stm32-hotspot/STM32WBA-Advanced-BLE-Broadcast-Speaker/Utilities/Media/speaker.png

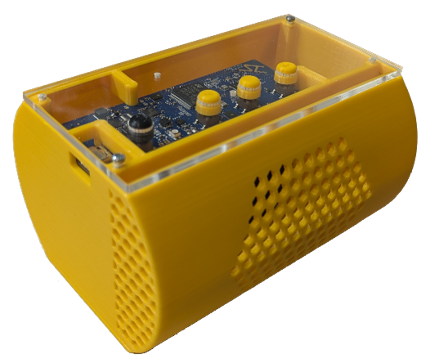
Utilities/Media/speaker.png
