stm32-hotspot/STM32WBA-Advanced-BLE-Broadcast-Speaker/Hardware/BLE_Speaker/BOM/BLE_Speaker_BOM.xlsx

 |  |  | Bill of materials
 |  |  | Board reference: | BLE_SPEAKER
 |  |  | Variant: | Variant for production
 |  |  | PCB revision: | revB
 |  |  | Assembly revision:
 |  |  | Date: | 11/8/2024
Designator | Description | Package | Manufacturer | Manufacturer_Part_Number | Fitted | Quantity | Alternate | Note
ANT1 | ST printed PCB Antenna for BLE miniboard and module |  | N/A | N/A | Fitted | 1
B1, B2, B3, B4 | Push Button, NO, 0.05A, 12V | 6,2x6,2mm | WURTH ELECTRONIK | 430182095816 | Fitted | 4
C1 | Capacitor, Tantalum, 100uF, 6V3, 40mR, +/-20%, Type_B (3528 metric), T=1.9mm | 3528 (metric) | AVX | TCJB107M006R0040 | Fitted | 1
C2, C9, C10, C14, C21, C23, C24, C25, C30, C31, C34, C35, C43, C46, C48, C56, C60, C65, C70, C74, C88, C93, C94, C95, C96, C100, C101 | Capacitor, MLCC, 100nF,10V, X5R, +/-10%, 0201, T=0.3mm | 0201 | TDK | C0603X5R1A104K030BC | Fitted | 27
C3, C5, C26, C73 | Capacitor, MLCC, 470nF, 25V, X5R, +/-10%, 0402, T=0.5mm | 0402 | YAGEO | CC0402KRX5R8BB474 | Fitted | 4
C4, C6, C20, C85 | Capacitor, MLCC, 330pF, 50V, NPO, +/-5%, 0402, T=0.5mm | 0402 | YAGEO | CC0402JRNPO9BN331 | Fitted | 4
C7, C8, C11, C33, C50, C51, C52, C53, C61, C62, C64, C68, C75, C78, C79, C81, C91, C92 | Capacitor, MLCC, 1uF, 10V, X5R, +/-10%, 0402, T=0.5mm | 0402 | YAGEO | CC0402KRX5R6BB105 | Fitted | 18
C12, C13, C19, C22, C37, C40, C41, C42, C54, C71, C72, C82, C83 | Capacitor, MLCC, 10uF, 6.3V, X5R, +/-20%, 0402, T=0.5mm | 0402 | MURATA | GRM155R60J106ME05D | Fitted | 13
C15, C16 | Capacitor, MLCC, 10pF, 50V, NPO, +/-5%, 0402, T=0.5mm | 0402 | YAGEO | CC0402JRNPO9BN100 | Fitted | 2
C27, C28, C29 | Capacitor, MLCC, 2.2pF, 50V, NPO, +/-0.1pF, 0402, T=0.5mm | 0402 | YAGEO | CC0402BRNPO9BN2R2 | Fitted | 3
C36, C39, C44, C45, C47, C49, C66, C69 | Capacitor, MLCC, 4.7uF, 6V3, X5R, +/-20%, 0402, T=0.5mm | 0402 | MURATA | GRM155R60J475ME47 | Fitted | 8
C63, C77 | Capacitor, MLCC, 2.2uF, 6V3, X5R,+/-10%, 0402, T=0.5mm | 0402 | MURATA | GRM155R60J225KE95D | Fitted | 2
C76, C84 | Capacitor, MLCC, 22uF, 10V, X5R, +/-20%, 0603, T=0.8mm | 0603 | YAGEO | CC0603MRX5R6BB226 | Fitted | 2
C80, C87 | Capacitor, MLCC, 10pF, 25V, NPO, +/-5%, 0201, T=0.3mm | 0201 | MURATA | GJM0335C1E100JB01 | Fitted | 2
C86 | Capacitor, MLCC, 33pF, 50V, NPO,+/-5%, 0402, T=0.5mm | 0402 | YAGEO | CC0402JRNPO9BN330 | Fitted | 1
CN6 | USB_TypeC, 24 pins, RA, SMD, T=3.71mm (USB Certified 3.1) |  | MOLEX | 2012670005 | Fitted | 1
L1, L2 | Ferrite bead, 600R @ 100MHz, +/-25%, 1300mA, 150mR, 0603, T=0.95mm | 0603 | MURATA | BLM18KG601SN1D | Fitted | 2
L3 | Inductor, 1.3nH, +/-0.3nH, 1A, 70mR, 0402, T=0.5mm | 0402 | MURATA | LQG15HS1N3S02 | Fitted | 1
L4, L5 | Inductor, 2.2uH, +/-20%, 2,2A, 84mR, 1008, T=1.2mm | 1008 | TOKO | DFE252012P-2R2M=P2 | Fitted | 2
L6 | Ferrite bead, 26R @ 100Mhz, +/-25%, 6000mA, 0R007, 0603, T=0.75mm | 0603 | MURATA | BLM18KG260TN1 | Fitted | 1
L7, L9 | Inductor, 3.3uH, +/-30%, 3,83A, 0R023, 4x4mm, T=2.5mm | 4x4mm | WURTH ELEKTRONIK | 74404043033A | Fitted | 2
L8 | Inductor, 4.7uH, +/-20%, 1.2A, 114mR, 4040, T=1.2mm | 4040 (Metric) | TAIYO YUDEN | LSXND4040MKL4R7MDG | Fitted | 1
LD1 | LED, Orange, 2V, 20mA, 0603 | 0603 | VISHAY | VLMO1300-GS08 | Fitted | 1
LD2 | LED Multicolor, Red/Green/Blue, 2V/3V2/3V2, 20mA, 2.8x3.2mm | 2.8x3.2mm | WURTH ELEKTRONIK | 150141M173100 | Fitted | 1
Q1 | Transistor, MOSFET, P-CH, -20V, -3.2A, SOT23-3 | SOT23-3 | ON SEMICONDUCTOR | NTR4101PT1G | Fitted | 1
R1, R19 | Resistor, 750K, 0402, +/-1%, 1/16W | 0402 | YAGEO | RC0402FR-07750KL | Fitted | 2
R2, R3, R20, R24 | Resistor, 10K, 0402, +/-1%, 1/16W | 0402 | YAGEO | RC0402FR-0710KL | Fitted | 4
R4, R9, R32, R33, R35 | Resistor, 100R, 0402, +/-1%, 1/16W | 0402 | YAGEO | RC0402FR-07100RL | Fitted | 5
R5, R10, R23, R28, R34, R36, R37, R38 | Resistor, 100K, 0402, +/-1%, 1/16W | 0402 | YAGEO | RC0402FR-07100KL | Fitted | 8
R6, R7 | Resistor, 51K, 0402, +/-1%, 1/16W | 0402 | YAGEO | RC0402FR-0751KL | Fitted | 2
R11 | Resistor, 49R9, 0402, +/-1%, 1/16W | 0402 | YAGEO | RC0402FR-0749R9L | Fitted | 1
R12, R15, R18, R29 | Resistor, 1K, 0402, +/-1%,1/16W | 0402 | YAGEO | RC0402FR-071KL | Fitted | 4
R13, R14 | Resistor, 5K1, 0402, +/-1%, 1/16W | 0402 | YAGEO | RC0402FR-075K1L | Fitted | 2
R17 | Resistor, 0R010, 1206 ,+/-1%, 1W | 1206 | PANASONIC | ERJ8CWFR010V | Fitted | 1
R21 | Resistor, 243K, 0402, +/-1%, 1/16W | 0402 | YAGEO | RC0402FR-07243KL | Fitted | 1
R22, R31 | Resistor, 560K, 0402, +/-1%, 1/16W | 0402 | YAGEO | RC0402FR-07560KL | Fitted | 2
R25 | NTC Thermistor, 10k, 0201, +/-1%@25°C, 100mW | 0201 | TDK | NTCG063JF103FTDS | Fitted | 1
R26 | Resistor, 10R, 0402, +/-1%, 1/16W | 0402 | YAGEO | RC0402FR-0710RL | Fitted | 1
R27 | Resistor, 2K49, 0402, +/-1%, 1/16W | 0402 | YAGEO | RC0402FR-072K49L | Fitted | 1
SB1, SB2, SB6, SB18, SB20 | Solder Bridge ON, 0R, 0201, 1/20W | 0201 | YAGEO | RC0201JR-070RL | Fitted | 5
U1 | Audio Amplifiers 1.2W audio pow. amp. |  | STMICROELECTRONICS | TS4962IQT | Fitted | 1
U2 | LDO Voltage Regulators Linear Voltage Regulators & Vref | DFN6 3x3 | STMICROELECTRONICS | LDL212PU50R | Fitted | 1
U3, U4 | MEMS, audio sensor, omnidirectional digital microphone | HCLGA-4 | STMICROELECTRONICS | MP34DT05TR | Fitted | 2
U5 | LDO, 200mA, Very low quiescent current linear regulator IC | DFN-4 | STMICROELECTRONICS | LD39020ADTPU18R | Fitted | 1
U6 | MCU,ARM Cortex M33,1MB Flash, 128KB SRAM, Crypto, RF 2.4GHz, BLE, 802.15.4 | UFQFPN48 7X7 0.55 | STMICROELECTRONICS | STM32WBA55CGU6 | Fitted | 1
U7 | IC, Gas gauge IC with alarm output for handheld applications | DFN-10 | STMICROELECTRONICS | STC3115AIQT | Fitted | 1
U9 | Stereo Codec, Ultra-Low power stereo audio codec | TQFN-EP-32 | ANALOG DEVICES | MAX9867ETJ+ | Fitted | 1
U11, U13, U14, U15, U16 | Diode, ESD TVS, 5V5, 1.5uA, 6V8, QFN1610 | QFN1610 | STMICROELECTRONICS | ESDA7P120-1U1M | Fitted | 5
U12 | High Efficiency USB Power Manager with Dual Buck and Buck-Boost DC/DC, 4.35 to 5.5 V Vin, 28-pin QFN (UFD-28), -40 to 85 degC, Pb-Free |  | Analog Devices / Linear Technology | LTC3556EUFD#PBF | Fitted | 1
U17 | ARM Microcontrollers - MCU Arm Cortex-M33 32-bit 250 MHz 2 Mbytes Flash 640KB RAM I3C, DCMI, Ethernet, SMPS |  | STMICROELECTRONICS | STM32H563VIT3Q | Fitted | 1 | STM32H573VIT3Q
U18 | IC, ESD protection and Common Filter High Speed serial Interfaces, 10.7 GHz | uQFN-6 | STMICROELECTRONICS | ECMF2-40A100N6 | Fitted | 1
X1 | Crystal, 32.768kHz, 9pF, +/-20ppm, 70KR, 1.6x1mm | 1.6x1.0mm | NDK | NX1610SE-32.768KHZ-EXS00A-MU01499 | Fitted | 1
X2 | Crystal, 32MHz, 8pF, +/-10ppm, 60R, 2x1.6mm | 2.0x1.6mm | NDK | NX2016SA-32MHZ-EXS00A-CS06654 | Fitted | 1
C17, C18 | Capacitor, MLCC, 3.9pF, 50V, NPO, +/-0.1pF, 0402, T=0.5mm | 0402 | YAGEO | CC0402BRNPO9BN3R9 | Not Fitted | 0
C32, C67, C98 | Capacitor, MLCC, 330pF, 50V, NPO, +/-5%, 0402, T=0.5mm | 0402 | YAGEO | CC0402JRNPO9BN331 | Not Fitted | 0
C38, C99 | Capacitor, MLCC, 1uF, 10V, X5R, +/-10%, 0402, T=0.5mm | 0402 | YAGEO | CC0402KRX5R6BB105 | Not Fitted | 0
C55, C97 | Capacitor, MLCC, 470nF, 25V, X5R, +/-10%, 0402, T=0.5mm | 0402 | YAGEO | CC0402KRX5R8BB474 | Not Fitted | 0
C57, C59 | Capacitor, MLCC, 10pF, 50V, NPO, +/-5%, 0402, T=0.5mm | 0402 | YAGEO | CC0402JRNPO9BN100 | Not Fitted | 0
C58 | Capacitor, MLCC, 100nF,10V, X5R, +/-10%, 0201, T=0.3mm | 0201 | TDK | C0603X5R1A104K030BC | Not Fitted | 0
C89 | Capacitor, MLCC, 10pF, 25V, NPO, +/-5%, 0201, T=0.3mm | 0201 | MURATA | GJM0335C1E100JB01 | Not Fitted | 0
C90 | Capacitor, MLCC, 10uF, 6.3V, X5R, +/-20%, 0402, T=0.5mm | 0402 | MURATA | GRM155R60J106ME05D | Not Fitted | 0
CN1, CN4 | Header, 2x1, 2.54mm, VR, TH, T=5.84mm/2.54mm |  | SAMTEC | TSW-102-07-G-S | Not Fitted | 0
CN2, CN5 | Header, 7x2, 1.27mm, VR, SMD, T=6.12mm |  | SAMTEC | FTSH-107-01-L-DV-K | Not Fitted | 0
CN3 | Connector_RF, 0Hz to 6GHz, 50R, VR, SMD, T= 1.25mm |  | HIROSE | U.FL-R-SMT-1 | Not Fitted | 0
CN7 | Header, 3x1, 2.54mm, VR, TH, T=6mm/3mm |  | JIUBABA | PHFS25-11-03-G0B115-T-1 | Not Fitted | 0
L10 | Inductor, 4.7uH, +/-20%, 1.2A, 114mR, 4040, T=1.2mm | 4040 (Metric) | TAIYO YUDEN | LSXND4040MKL4R7MDG | Not Fitted | 0
L11, L12 | Ferrite bead, 600R @ 100MHz, +/-25%, 1300mA, 150mR, 0603, T=0.95mm | 0603 | MURATA | BLM18KG601SN1D | Not Fitted | 0
R8, R39, R40, R43 | Resistor, 120K, 0402, +/-0.1%, 1/16W, +/-25ppm/°C | 0402 | YAGEO | RT0402BRD07120KL | Not Fitted | 0
R30 | Resistor, 750K, 0402, +/-1%, 1/16W | 0402 | YAGEO | RC0402FR-07750KL | Not Fitted | 0
R41, R42 | Resistor, 51K, 0402, +/-1%, 1/16W | 0402 | YAGEO | RC0402FR-0751KL | Not Fitted | 0
SB3, SB4, SB5, SB7, SB15, SB16 | Solder Bridge ON, 0R, 0201, 1/20W | 0201 | YAGEO | RC0201JR-070RL | Not Fitted | 0
U8 | Audio Amplifiers 1.2W audio pow. amp. | DFN8 3x3 p0.65 |  | TS4990IQT | Not Fitted | 0
X3 | Crystal, 32.768kHz, 9pF, +/-20ppm, 70KR, 1.6x1mm | 1.6x1.0mm | NDK | NX1610SE-32.768KHZ-EXS00A-MU01499 | Not Fitted | 0
