stm32-hotspot/STM32WBA-Advanced-BLE-Broadcast-Speaker/3D_Printings/Speaker_button_minus.stl

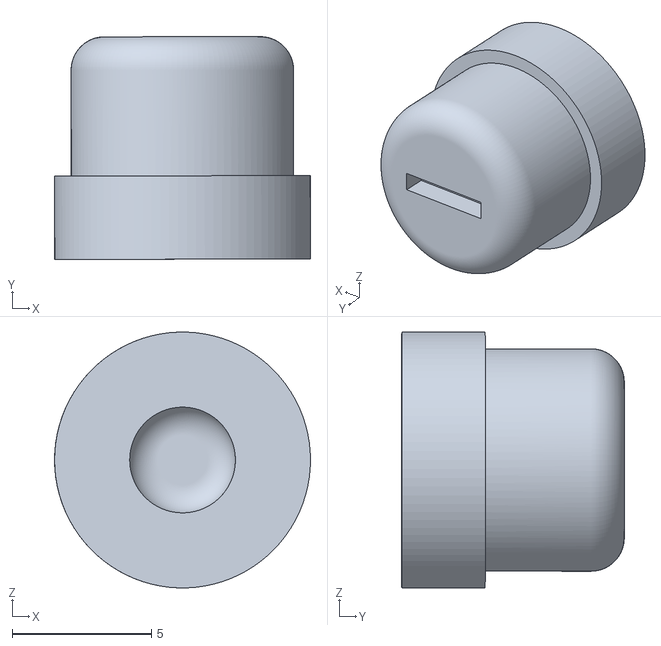
[picture p14: CAD file, 2025-11-28]
3D_Printings/Speaker_button_minus.stl
9.20 x 8.01 x 9.19
