stm32-hotspot/STM32WBA-Advanced-BLE-Broadcast-Speaker/3D_Printings/Speaker_button_plus.stl

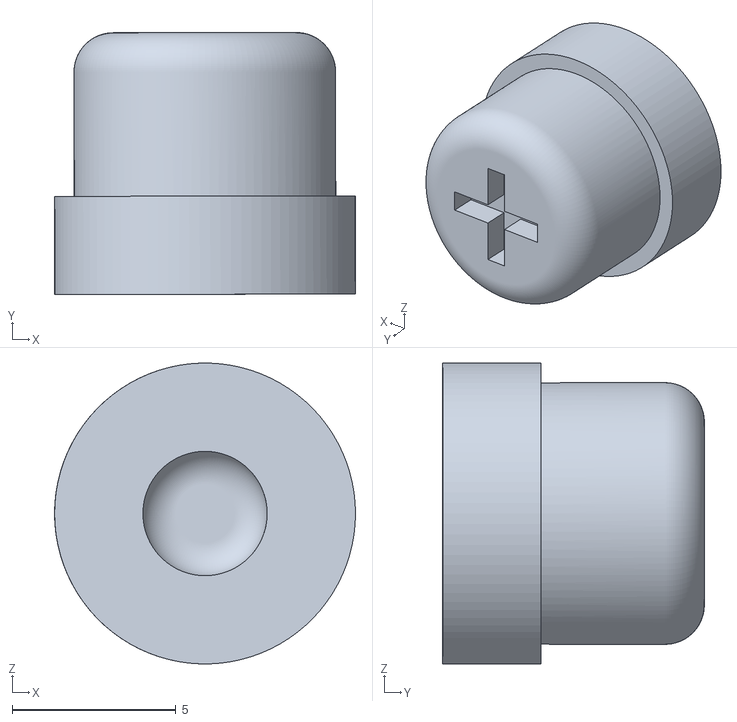
[picture p15: CAD file, 2025-11-28]
3D_Printings/Speaker_button_plus.stl
9.20 x 8.01 x 9.19
