stm32-hotspot/STM32WBA-Advanced-BLE-Broadcast-Speaker/3D_Printings/Speaker_bottom_cover.stl

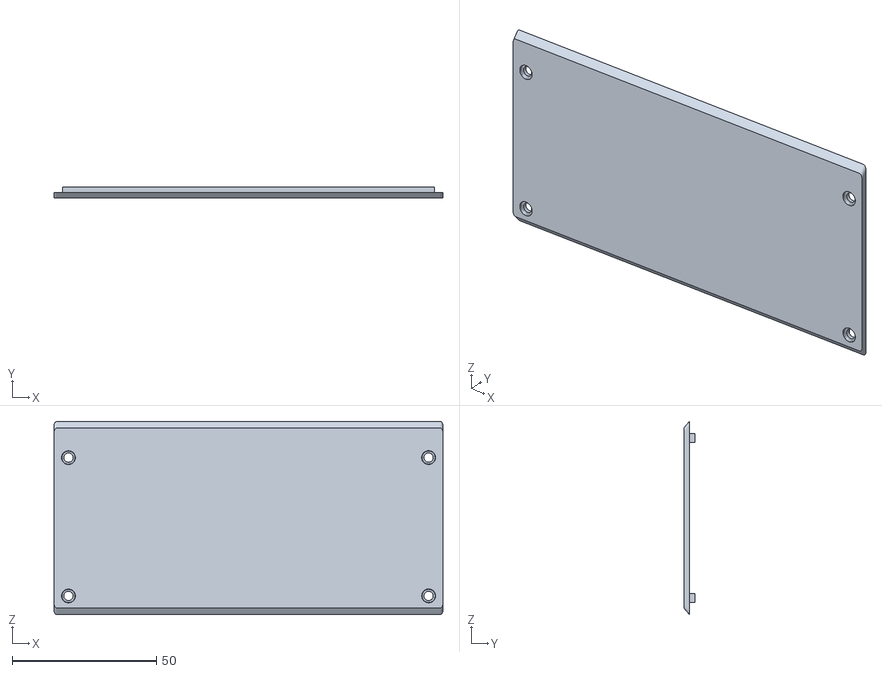
[picture p16: CAD file, 2025-11-28]
3D_Printings/Speaker_bottom_cover.stl
135.0 x 3.97 x 67.1
