stm32-hotspot/STM32WBA-Advanced-BLE-Broadcast-Speaker/3D_Printings/Speaker_top_cover_PMMA.dxf

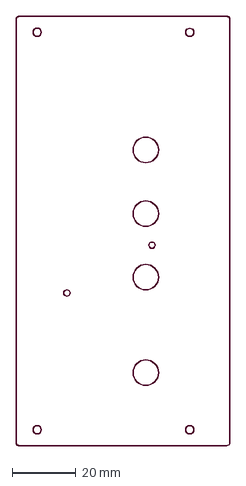
[picture p17: CAD file, 2025-11-28]
3D_Printings/Speaker_top_cover_PMMA.dxf
67.3 x 135.0 mm
