stm32-hotspot/STM32WBA-Advanced-BLE-Broadcast-Speaker/3D_Printings/Speaker_body.stl

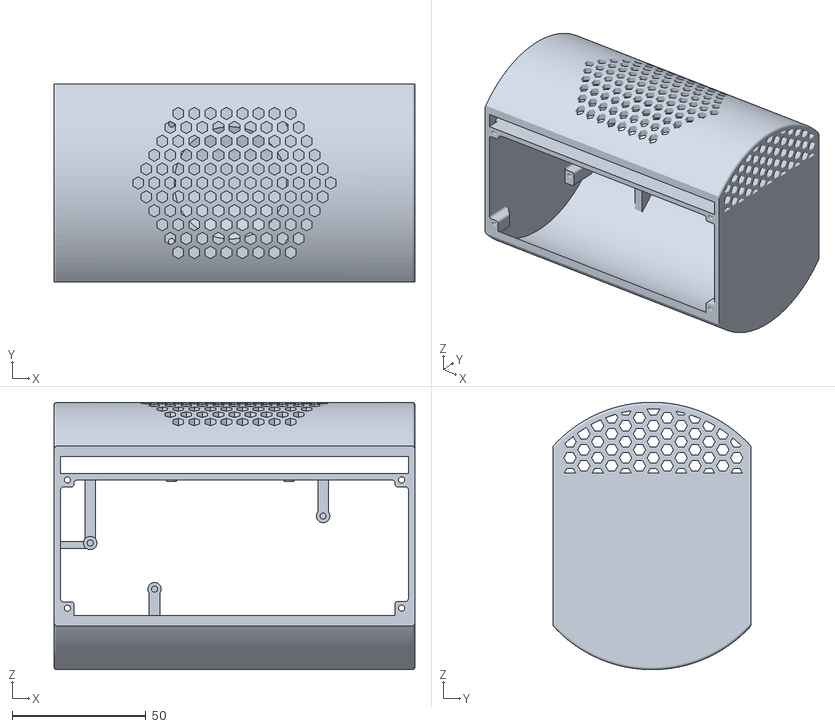
[picture p18: CAD file, 2025-11-28]
3D_Printings/Speaker_body.stl
135.0 x 74.0 x 100.0
