stm32-hotspot/STM32WBA-Advanced-BLE-Broadcast-Speaker/3D_Printings/Speaker_button_generic.stl

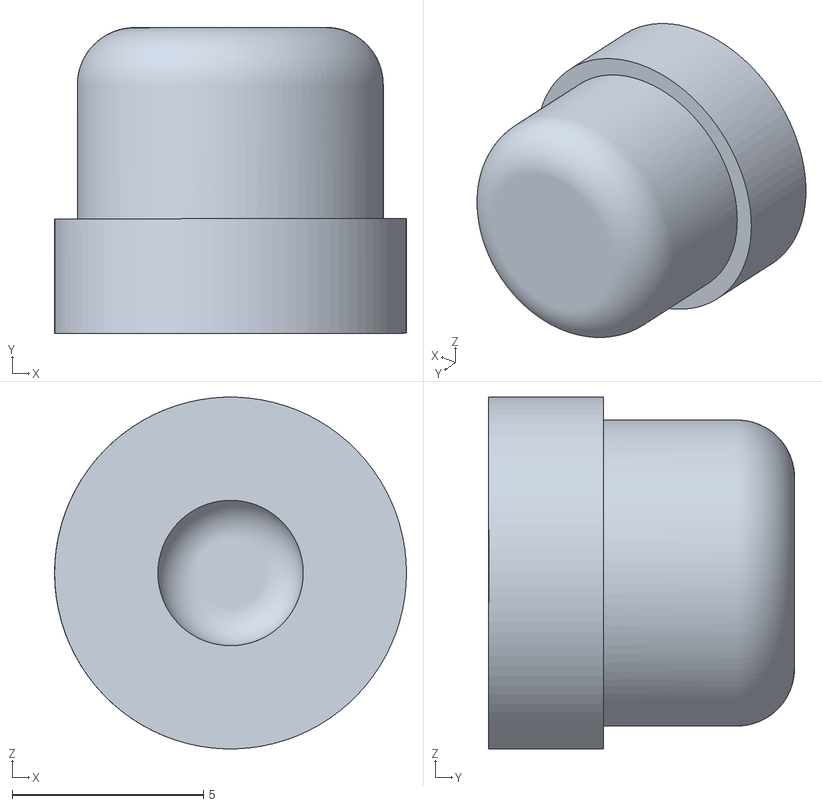
[picture p19: CAD file, 2025-11-28]
3D_Printings/Speaker_button_generic.stl
9.20 x 8.01 x 9.19
