stm32-hotspot/STM32WBA-Advanced-BLE-Broadcast-Speaker/Release_Notes.html

# Release Notes for

# STM32WBA-Advanced-BLE-Broadcast-Speaker demonstration

Copyright © 2025 STMicroelectronics

ST logo (https://www.st.com)

# Purpose

This package contains specific applications running on BLE Speaker board and STM32WBA55G-DK or STM32WBA65I-DK discovery kits. See README.md files for more details.

This example is based on the STM32CubeWBA_v1.7.0 (https://github.com/STMicroelectronics/STM32CubeWBA/releases/tag/v1.7.0) package and on the x-cube-audio-kit v1.3.0 (https://www.st.com/en/embedded-software/x-cube-audio-kit.html).

For further information about these components, see official package.

BLE_Audio_Broadcast_Speaker and BLE_Audio_PBP_Source_Multilanguage examples are being delivered as-is, not necessarily supported by ST.

Modified x-cube-audio-kit (Livetune) example is being delivered as-is, not necessarily supported by ST.

# Update History

V1.0.0 / 27-November-2025

## Main Changes

### Initial release of BLE_Audio_Broadcast_Speaker and BLE_Audio_PBP_Source_Multilanguage applications running on respectively STM32WBA55 component of BLE_Speaker board and STM32WBA55G-DK or STM32WBA65I-DK discovery kits

### Initial release of Livetune application running on STM32H573 component of BLE_Speaker board

## Components

### Refer to Release Notes of official STM32CubeWBA v1.7.0 package for details of Components (Drivers, Cortex-M CMSIS, STM32 CMSIS, STM32WBAxx_HAL_Driver, STM32WBAxxx-DK1, Middlewares, Utilities)

### Refer to Release Notes of official x-cube-audio-kit v1.3.0 package for details of Components (Drivers, Cortex-M CMSIS, STM32H5xx CMSIS, STM32H5xx_HAL_Driver, Middlewares, Utilities)

## Known Limitations

### None

## Development Toolchains and Compilers

### IAR Embedded Workbench for ARM (EWARM) toolchain from v9.60.3 + ST-Link for STM32WBA related project

### IAR Embedded Workbench for ARM (EWARM) toolchain from v9.40.1 + ST-Link for STM32H5 related project

### RealView Microcontroller Development Kit (MDK-ARM) 5.38

### STM32Cube IDE 1.18.1 + ST-Link

## Supported Devices and Boards

### BLE_Speaker board

### STM32WBA55G-DK1 board

### STM32WBA65I-DK1 board

## Dependencies

### None

For complete documentation on STM32WBAxx, visit: [www.st.com/stm32wba]

For complete documentation on STM32H5xx, visit: [www.st.com/stm32h5 (https://www.st.com/en/microcontrollers-microprocessors/stm32h5-series.html)]

This release note uses up to date web standards and, for this reason, should not be opened with Internet Explorer but preferably with popular browsers such as Google Chrome, Mozilla Firefox, Opera or Microsoft Edge.
