stm32-hotspot/STM32WBA-Advanced-BLE-Broadcast-Speaker/Hardware/BLE_Speaker/Schematic/BLE_Speaker_Schematic.PDF

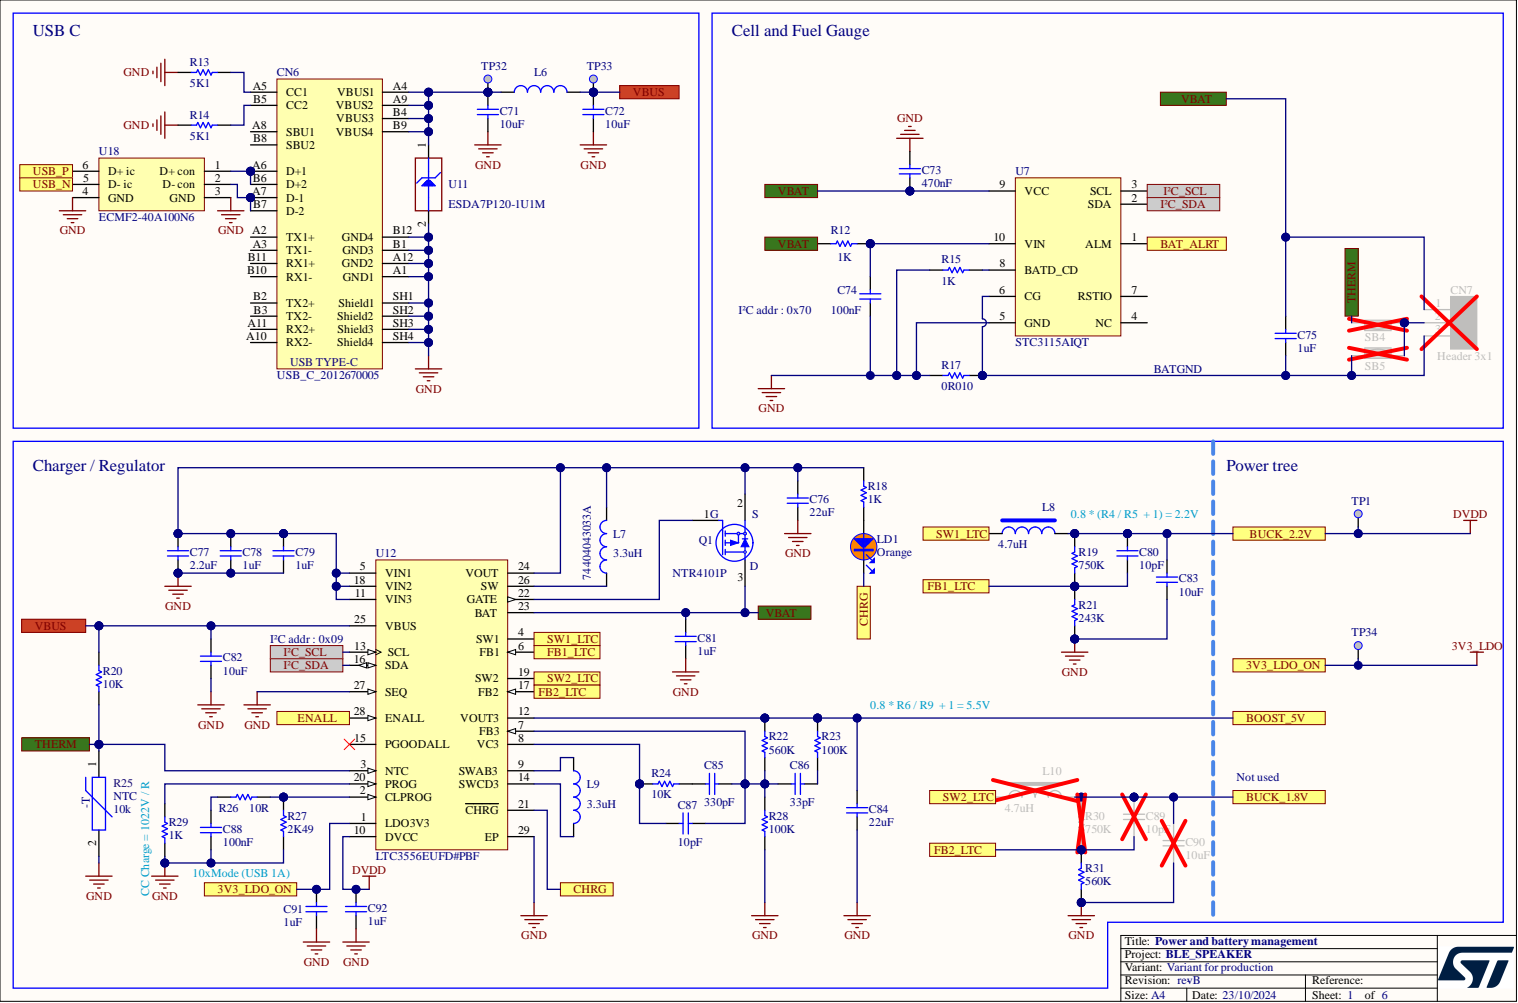
[picture p21: page 1]

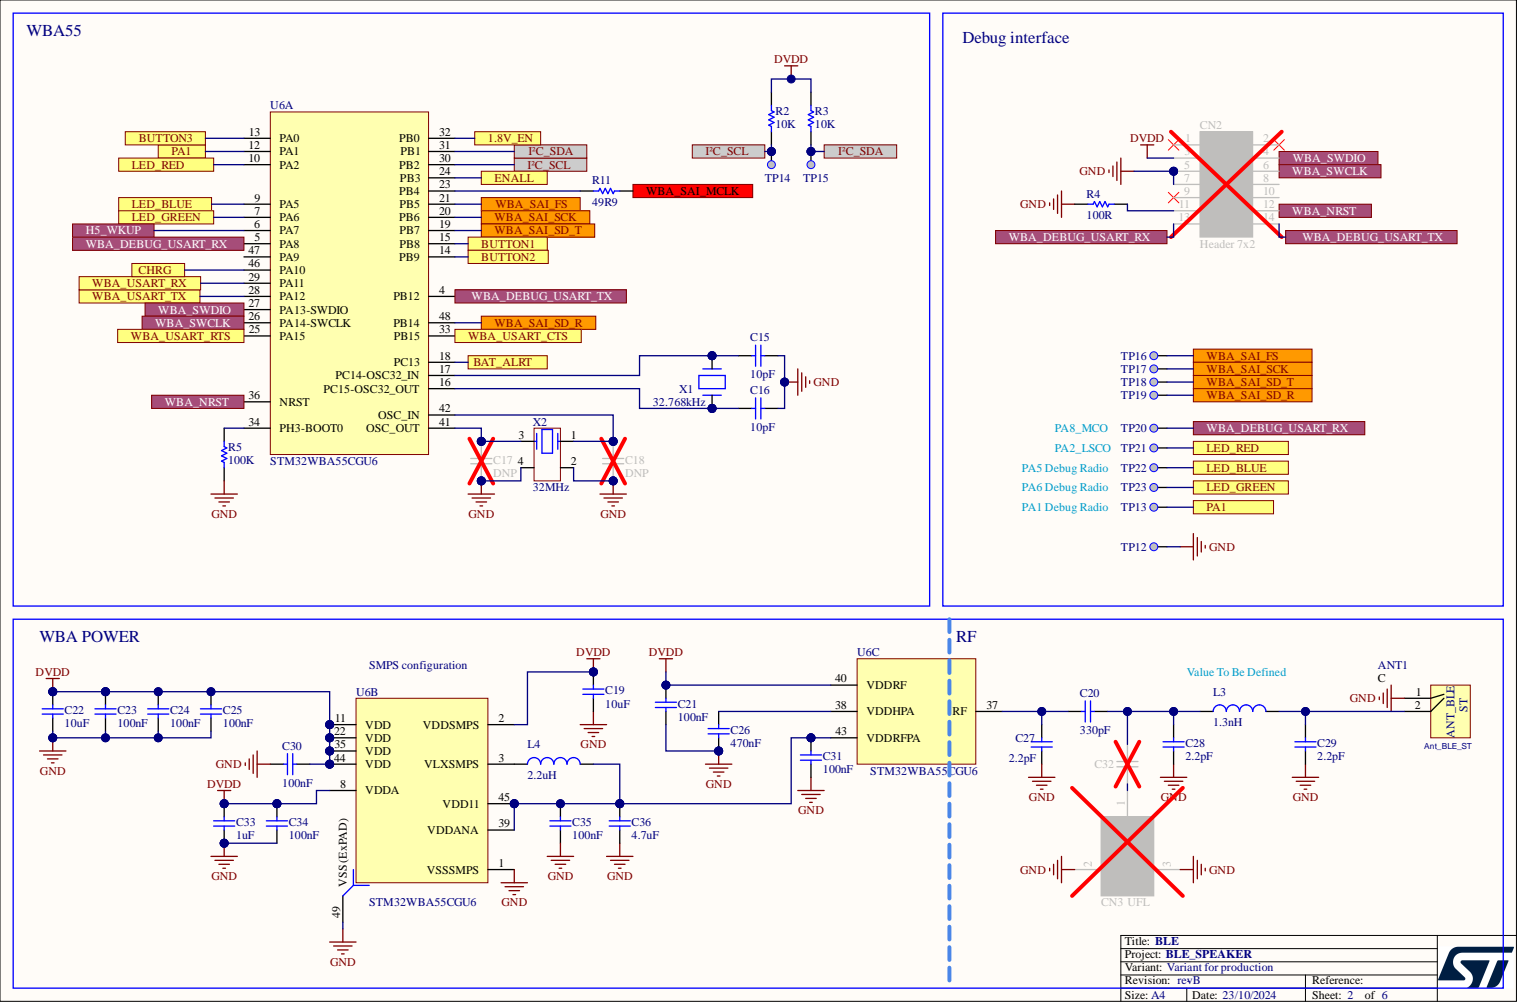
[picture p22: page 2]

Value To Be Defined

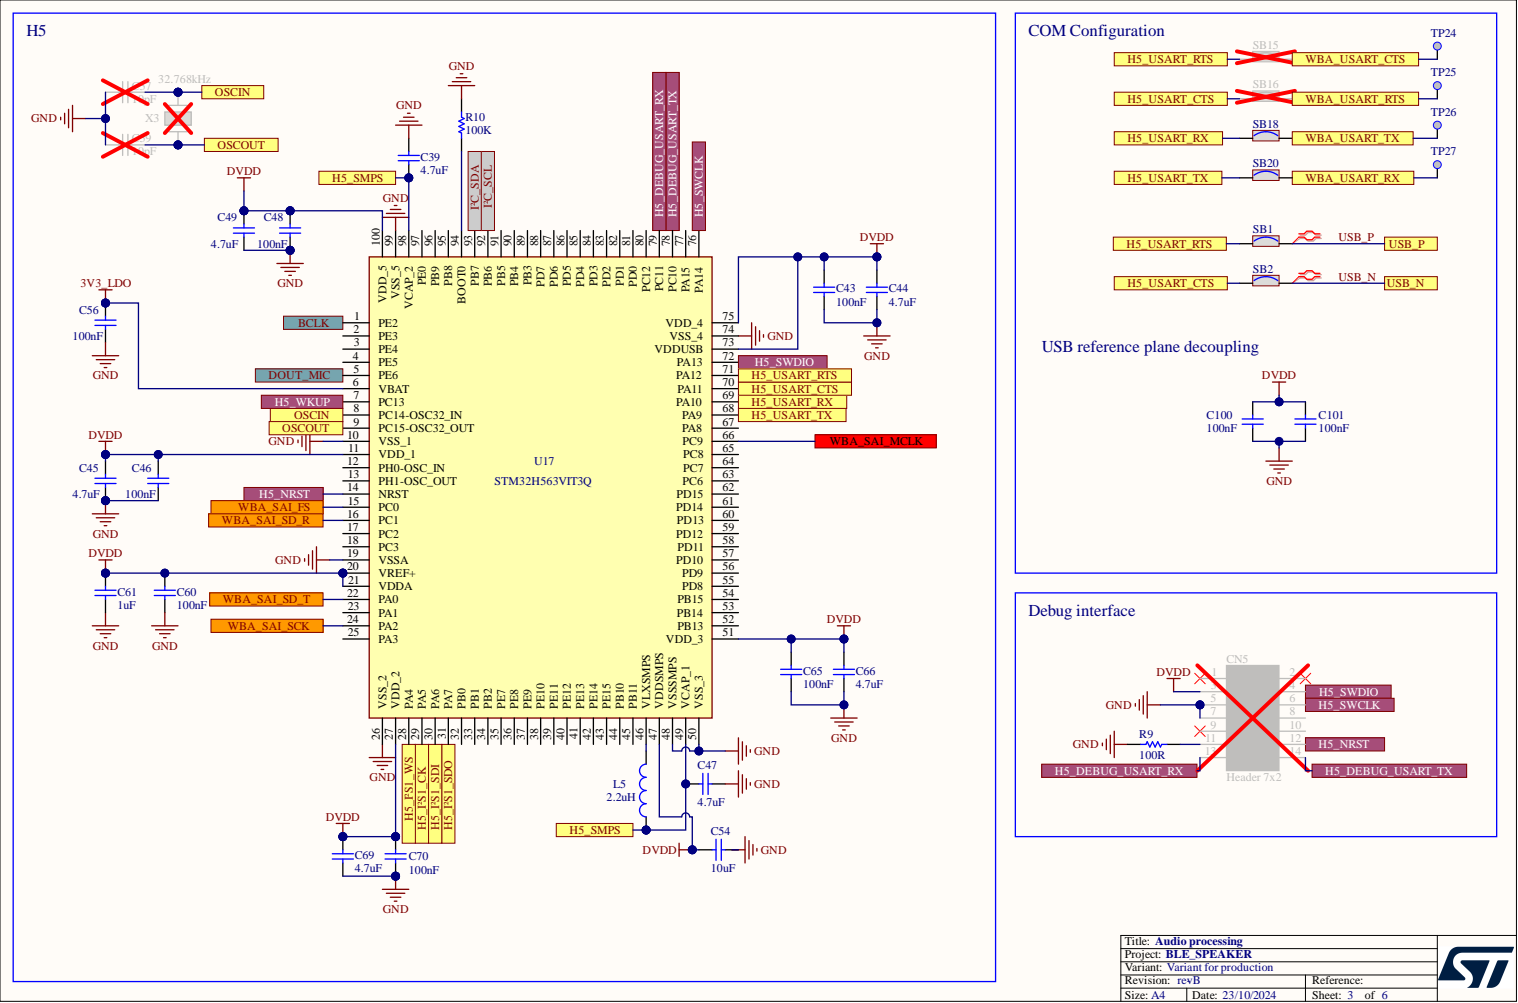
[picture p23: page 3]

2 | 7 4
3 | 7 3

USB reference plane decoupl

D O U T _ M I C | | | H 5 _ USA RT _RT S

5 | 7 1
6 | 7 0

1 5 | 6 1
1 6 | 6 0

2 0 | 5 6
2 1 | 5 5

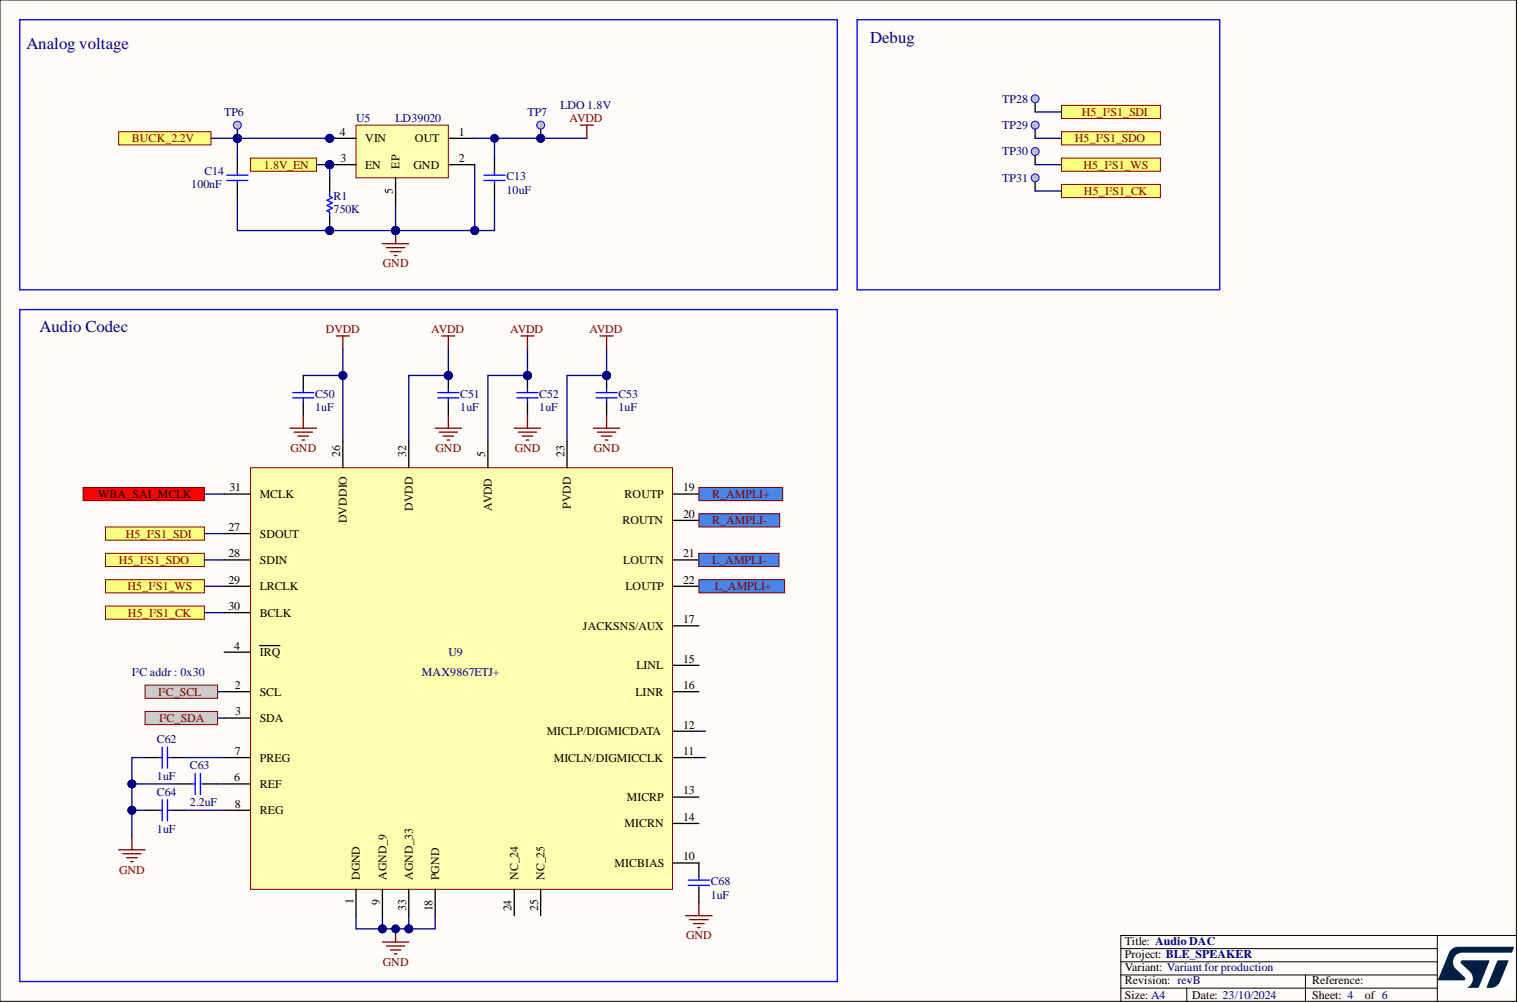
[picture p24: page 4]

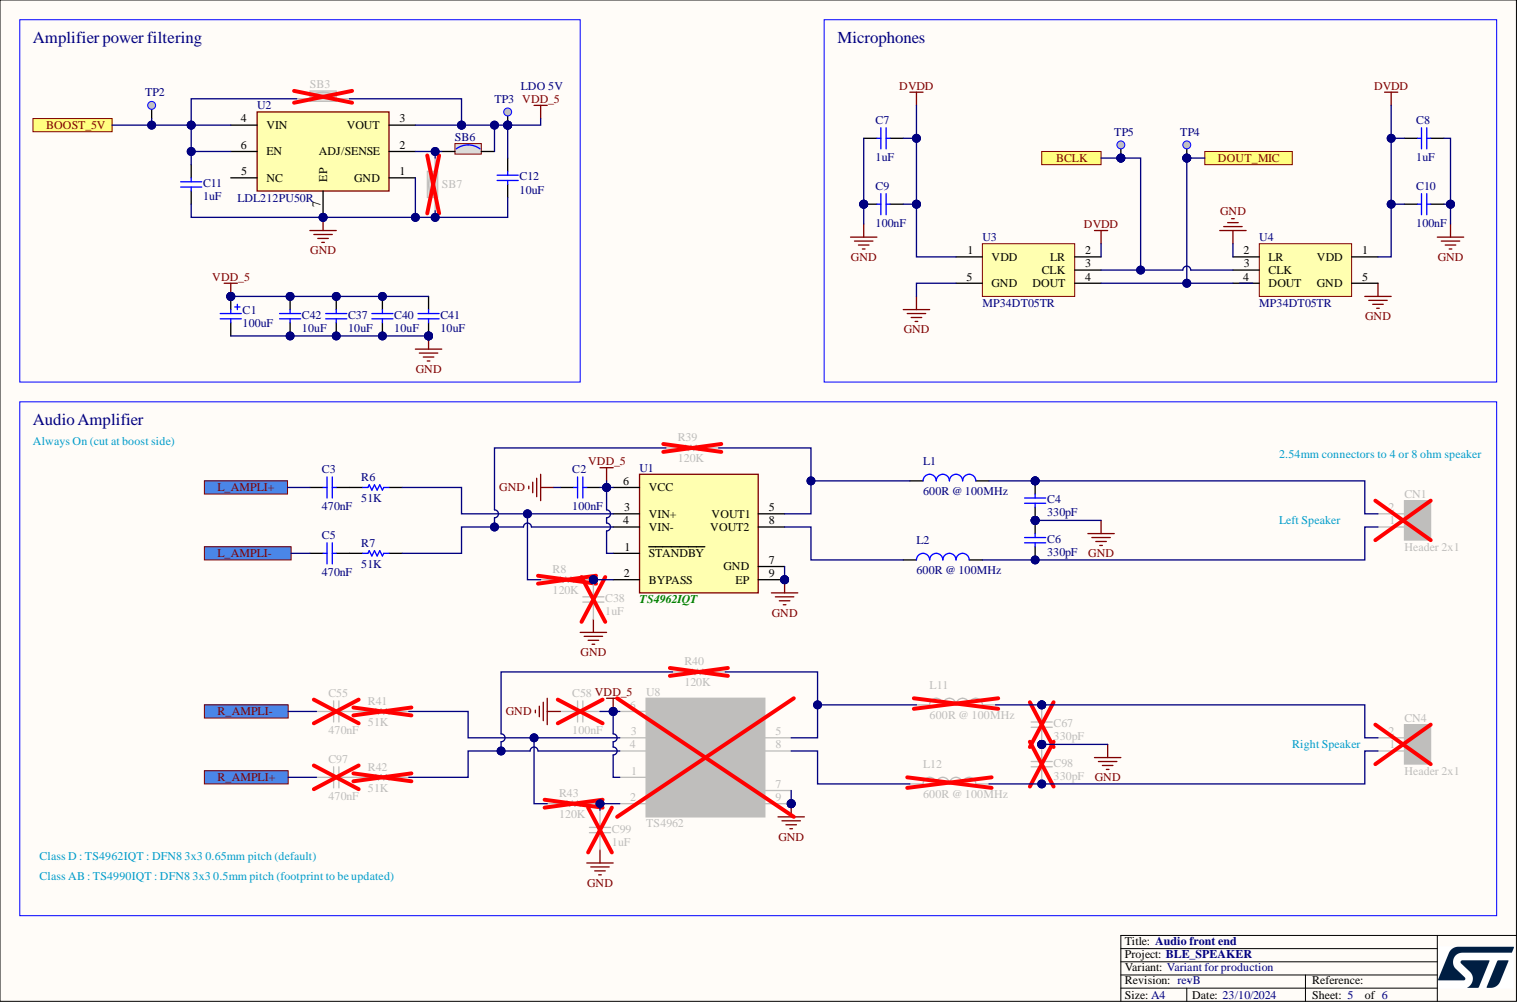
[picture p25: page 5]

Always On (cut at boost side)

2.54mm connectors to 4 or 8 ohm speaker

VCC 6

100nF | VIN+ 3

VCC 6 VIN+ 3 | VOUT2 GND

VIN- 4 | 8 | 1 1 2 2

STANDBY 1 | 7

Class D : TS4962IQT : DFN8 3x3 0.65mm pitch (default)
Class AB : TS4990IQT : DFN8 3x3 0.5mm pitch (footprint to be updated)

Title: Audio front end

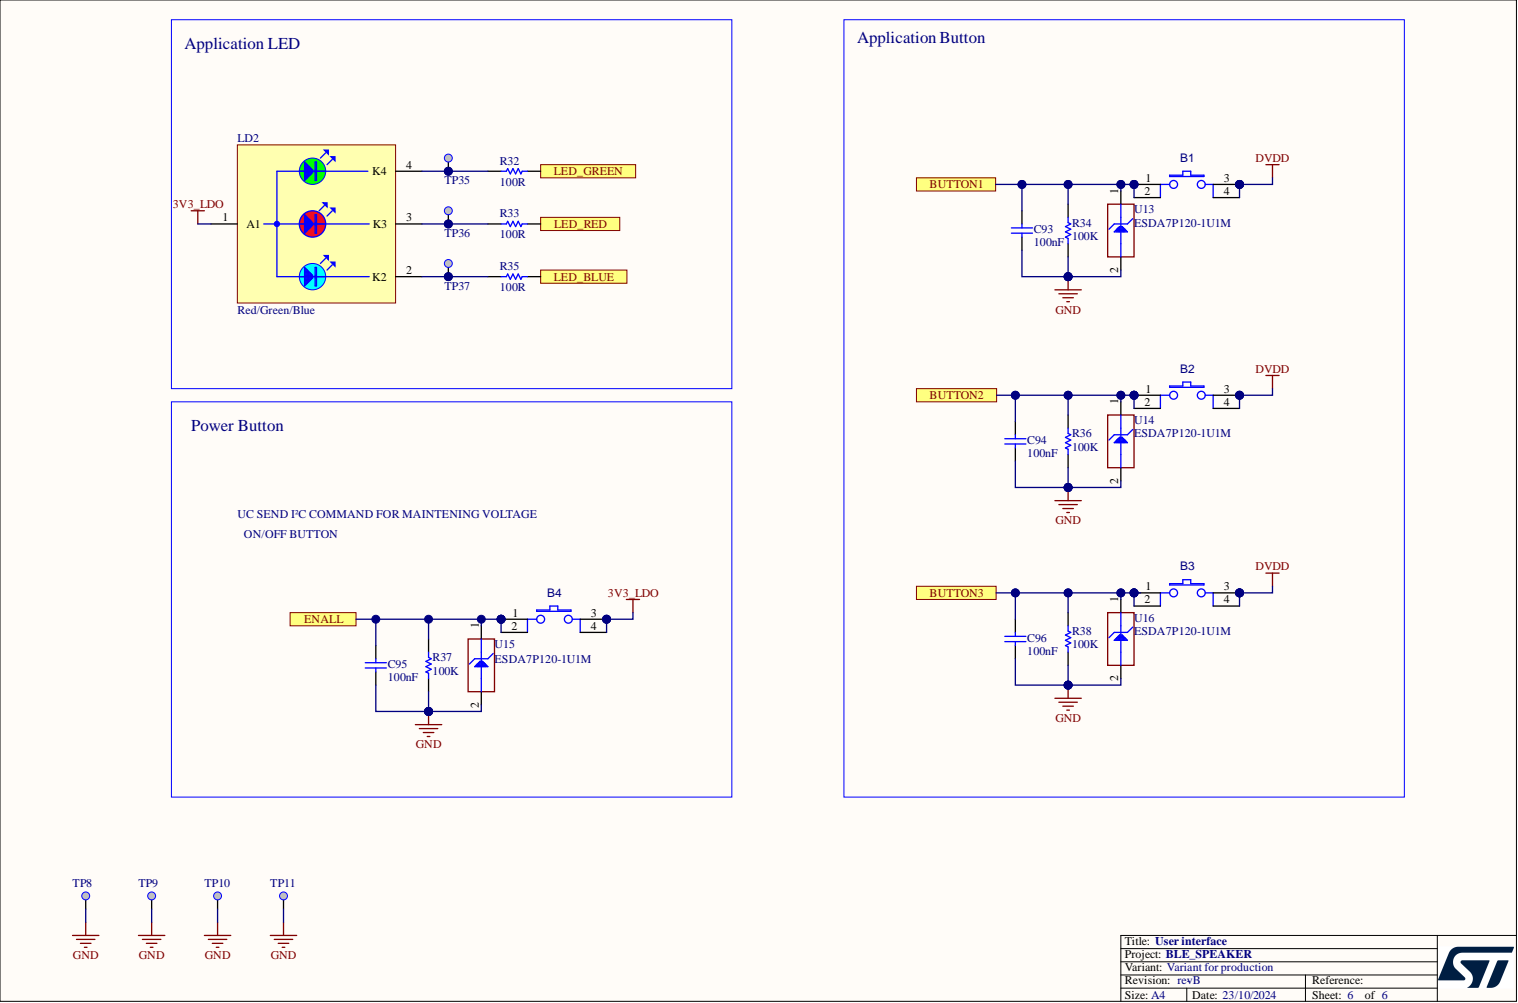
[picture p26: page 6]

UC SEND I²C COMMAND FOR MAINTENING VOLTAGE
ON/OFF BUTTON
