stm32-hotspot/STM32WBA-Advanced-BLE-Broadcast-Speaker/Hardware/BLE_Speaker/Manufacturing/Assembly/BLE_Speaker_revB_Assembly.PDF

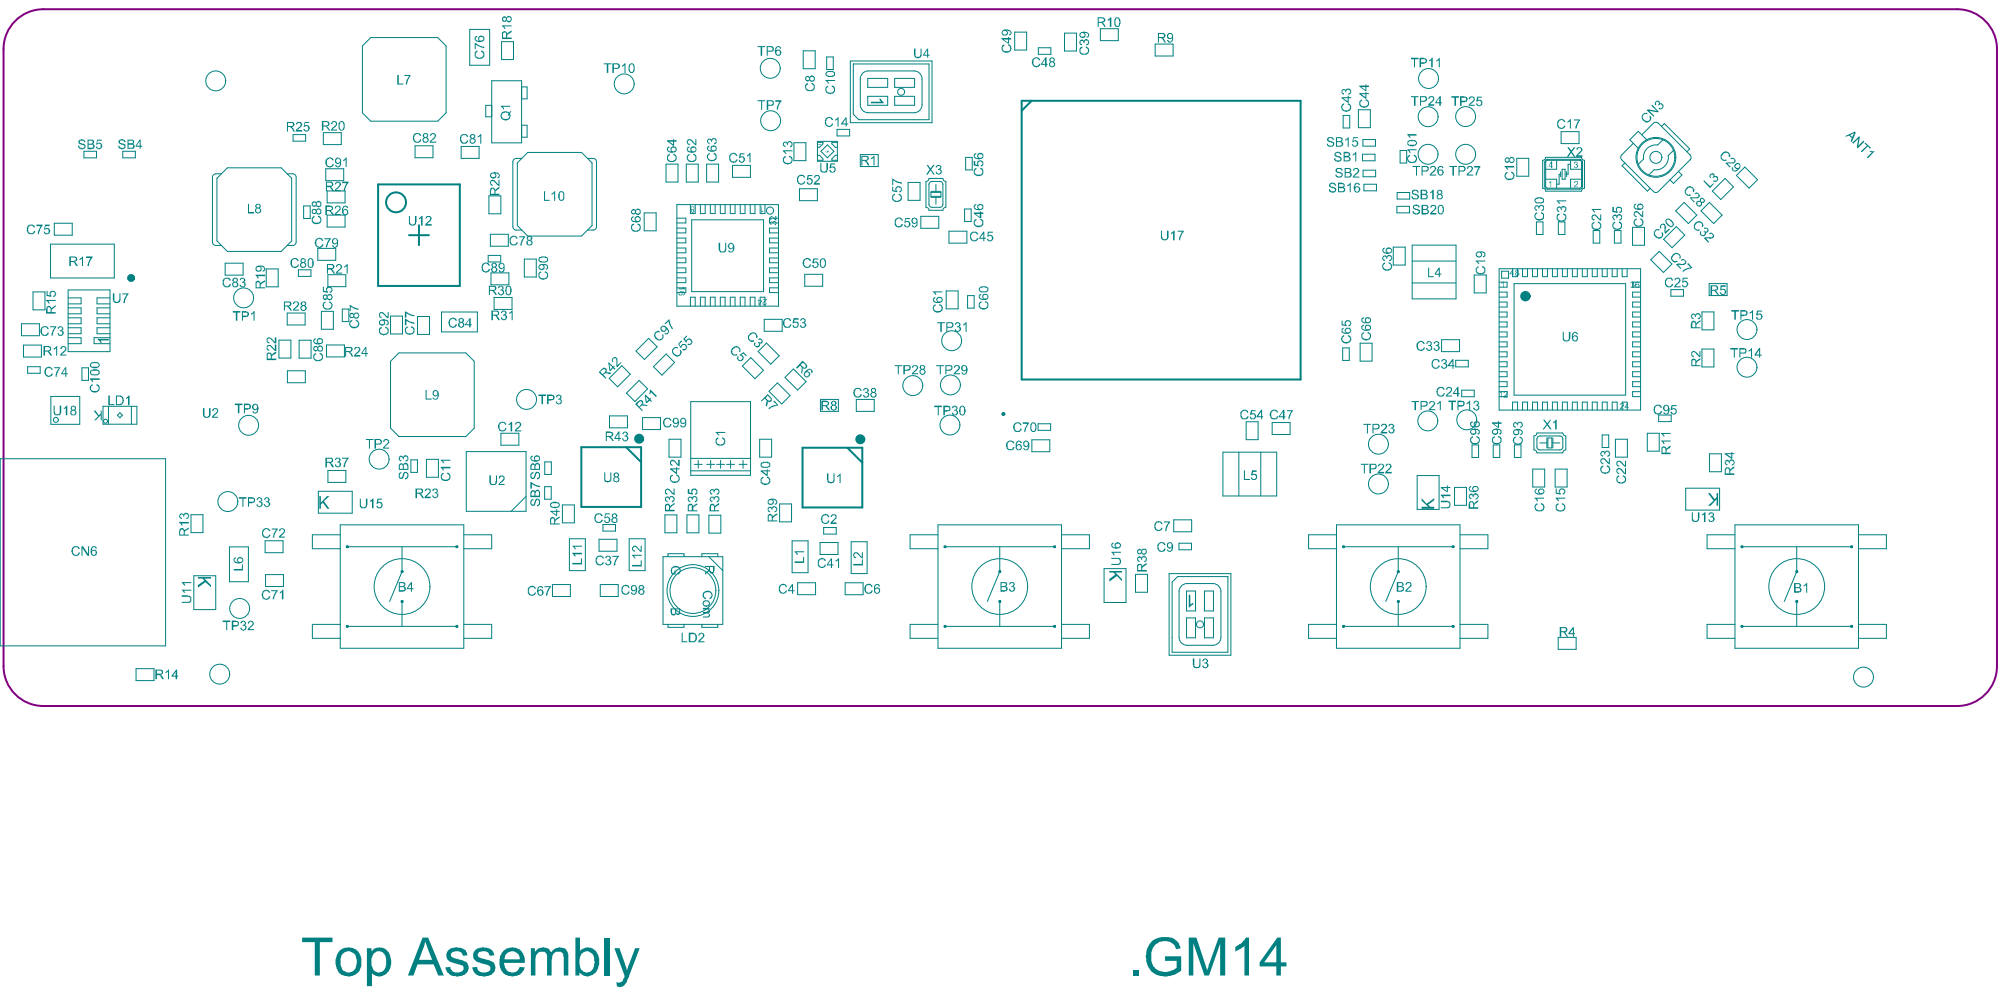
[picture p27: page 1]

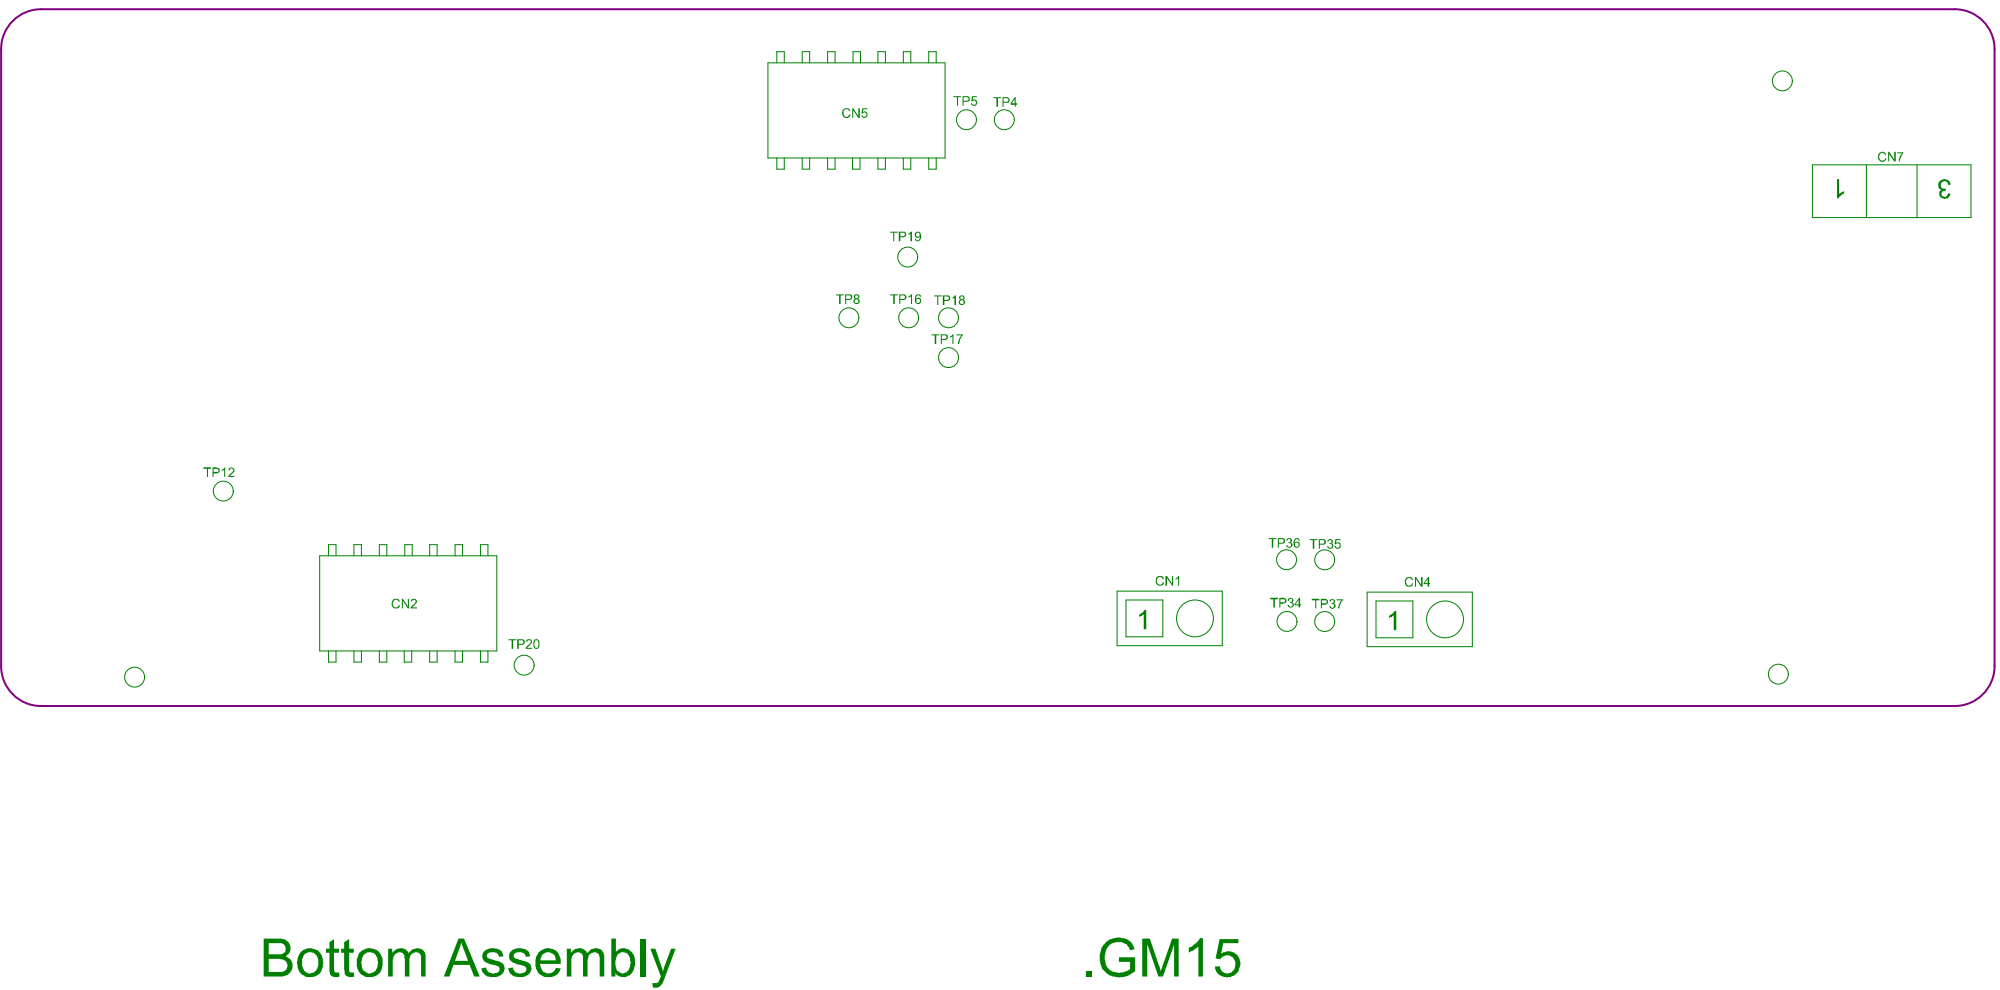
[picture p28: page 2]
