stm32-hotspot/STM32WBA-Advanced-BLE-Broadcast-Speaker/Projects/BLE_Speaker/Applications/BLE/BLE_Audio_Broadcast_Speaker/Core/Src/main.c

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
/* Includes ------------------------------------------------------------------*/
#include "main.h"

/* USER CODE BEGIN Includes */
#include "board_mngr.h"
/* USER CODE END Includes */


CRC_HandleTypeDef hcrc;

DMA_HandleTypeDef handle_GPDMA1_Channel2;
DMA_HandleTypeDef handle_GPDMA1_Channel1;

I2C_HandleTypeDef hi2c3;

RAMCFG_HandleTypeDef hramcfg_SRAM1;
RAMCFG_HandleTypeDef hramcfg_SRAM2;

RNG_HandleTypeDef hrng;

RTC_HandleTypeDef hrtc;

TIM_HandleTypeDef htim1;

UART_HandleTypeDef huart1;
DMA_HandleTypeDef handle_GPDMA1_Channel6;
DMA_HandleTypeDef handle_GPDMA1_Channel0;

void SystemClock_Config(void);
void PeriphCommonClock_Config(void);
static void MX_I2C3_Init(void);
static void MX_TIM1_Init(void);

/**
  * @brief  The application entry point.
  * @retval int
  */
int main(void)
{

  /* MCU Configuration--------------------------------------------------------*/

  /* Reset of all peripherals, Initializes the Flash interface and the Systick. */
  HAL_Init();
  /* Config code for STM32_WPAN (HSE Tuning must be done before system clock configuration) */
  MX_APPE_Config();

  /* Configure the system clock */
  SystemClock_Config();

  /* Configure the peripherals common clocks */
  PeriphCommonClock_Config();

  /* Initialize all configured peripherals */
  MX_GPIO_Init();
  MX_GPDMA1_Init();
  MX_RAMCFG_Init();
  MX_RTC_Init();
  MX_CRC_Init();
  MX_ICACHE_Init();
  MX_I2C3_Init();
  MX_TIM1_Init();
  /* Init code for STM32_WPAN */
  MX_APPE_Init(NULL);

  /* Infinite loop */
  /* USER CODE BEGIN WHILE */
  BoardInit();

  while (1)
  {
    /* USER CODE END WHILE */
    MX_APPE_Process();

    /* USER CODE BEGIN 3 */
  }
  /* USER CODE END 3 */
}

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
/* USER CODE BEGIN 4 */
void HAL_GPIO_EXTI_Rising_Callback(uint16_t GPIO_Pin)
{
  if(GPIO_Pin == SPEAKER_FUELG_IT_PIN)
  {
    Sys_Notify_Evt(FUEL_GAUGE_IT);
  }
  if(GPIO_Pin == SPEAKER_CHG_IT_PIN)
  {
    Sys_Notify_Evt(STOP_CHRG);
  }
  if(GPIO_Pin == SPEAKER_BP3_PIN)
  {
    Button_rising_evnt(BUTTON_3);
  }
  if(GPIO_Pin == SPEAKER_BP2_PIN)
  {
    Button_rising_evnt(BUTTON_2);
  }
  if(GPIO_Pin == SPEAKER_BP1_PIN)
  {
    Button_rising_evnt(BUTTON_1);
  }
  if(GPIO_Pin == SPEAKER_BP_POWER_PIN)
  {
    Button_rising_evnt(BUTTON_PWR);
  }
}

void HAL_GPIO_EXTI_Falling_Callback(uint16_t GPIO_Pin)
{
  if(GPIO_Pin == SPEAKER_CHG_IT_PIN)
  {
    Sys_Notify_Evt(START_CHRG);
  }
  if(GPIO_Pin == SPEAKER_BP3_PIN)
  {
    Button_falling_evnt(BUTTON_3);
  }
  if(GPIO_Pin == SPEAKER_BP2_PIN)
  {
    Button_falling_evnt(BUTTON_2);
  }
  if(GPIO_Pin == SPEAKER_BP1_PIN)
  {
    Button_falling_evnt(BUTTON_1);
  }
  if(GPIO_Pin == SPEAKER_BP_POWER_PIN)
  {
    Button_falling_evnt(BUTTON_PWR);
  }
}

/* USER CODE END 4 */
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
