stm32-hotspot/STM32WBA-Advanced-BLE-Broadcast-Speaker/Projects/STM32WBA55G-DK1/Applications/BLE/BLE_Audio_Broadcast_Speaker/BLE_Audio_Broadcast_Speaker.ioc

Mcu.UserName=STM32WBA55CGUx
PA0.Signal=SPI3_SCK
PA6.Signal=I2C3_SCL
PA7.Signal=I2C3_SDA
PA8.Signal=USART1_RX
PB12.Signal=USART1_TX
PB14.Signal=SAI1_SD_A
PB5.Signal=SAI1_FS_B
PB6.Signal=SAI1_SCK_B
PB7.Signal=SAI1_SD_B
PB8.Signal=SPI3_MOSI
PC14-OSC32_IN.Signal=RCC_OSC32_IN
PC15-OSC32_OUT.Signal=RCC_OSC32_OUT
