stm32-hotspot/STM32WBA-Advanced-BLE-Broadcast-Speaker/Projects/BLE_Speaker/Applications/BLE/BLE_Audio_Broadcast_Speaker/STM32_WPAN/App/tmap_app.h

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

/* Define to prevent recursive inclusion -------------------------------------*/
#ifndef __TMAP_APP_H
#define __TMAP_APP_H

#ifdef __cplusplus
extern "C" {
#endif

/* Includes ------------------------------------------------------------------*/
#include "stm32wbaxx_hal.h"
#include "tmap.h"
#include "tmap_app_conf.h"
#include "app_conf.h"

/* Exported constants --------------------------------------------------------*/

#define NUM_LC3_CODEC_CAP       16
#define NUM_LC3_CODEC_CONFIG    16
#define LC3_8_1                 0
#define LC3_8_2                 1
#define LC3_16_1                2
#define LC3_16_2                3
#define LC3_24_1                4
#define LC3_24_2                5
#define LC3_32_1                6
#define LC3_32_2                7
#define LC3_441_1               8
#define LC3_441_2               9
#define LC3_48_1                10
#define LC3_48_2                11
#define LC3_48_3                12
#define LC3_48_4                13
#define LC3_48_5                14
#define LC3_48_6                15

#define NUM_LC3_QoSConf         32
#define LC3_QOS_8_1_1           0
#define LC3_QOS_8_2_1           1
#define LC3_QOS_16_1_1          2
#define LC3_QOS_16_2_1          3
#define LC3_QOS_24_1_1          4
#define LC3_QOS_24_2_1          5
#define LC3_QOS_32_1_1          6
#define LC3_QOS_32_2_1          7
#define LC3_QOS_441_1_1         8
#define LC3_QOS_441_2_1         9
#define LC3_QOS_48_1_1          10
#define LC3_QOS_48_2_1          11
#define LC3_QOS_48_3_1          12
#define LC3_QOS_48_4_1          13
#define LC3_QOS_48_5_1          14
#define LC3_QOS_48_6_1          15
#define LC3_QOS_8_1_2           16
#define LC3_QOS_8_2_2           17
#define LC3_QOS_16_1_2          18
#define LC3_QOS_16_2_2          19
#define LC3_QOS_24_1_2          20
#define LC3_QOS_24_2_2          21
#define LC3_QOS_32_1_2          22
#define LC3_QOS_32_2_2          23
#define LC3_QOS_441_1_2         24
#define LC3_QOS_441_2_2         25
#define LC3_QOS_48_1_2          26
#define LC3_QOS_48_2_2          27
#define LC3_QOS_48_3_2          28
#define LC3_QOS_48_4_2          29
#define LC3_QOS_48_5_2          30
#define LC3_QOS_48_6_2          31

/*Audio Configuration specified in Basic Audio Profile Specification*/
#define NUM_USR_AUDIO_CONF      (16u)
#define USR_AUDIO_CONF_1        0       /* Single Audio Channel. One unidirectional CIS. Unicast Server is Audio Sink
                                         * Mandatory :
                                         *      - 1 Sink PAC
                                         *              Supported_Audio_Channel_Counts : Optional (if present, include at least SUPPORTED_AUDIO_CHNL_COUNT_1)
                                         *      - 1 Sink ASE
                                         *              Audio_Channel_Allocation : Optional (if present, match with Sink Audio Locations)
                                         * Optional :
                                         *      - Sink Audio Locations
                                         */
#define USR_AUDIO_CONF_2        1       /* Single Audio Channel. One unidirectional CIS. Unicast Server is Audio Source.
                                         * Mandatory :
                                         *      - 1 Source PAC
                                         *              Supported_Audio_Channel_Counts : Optional (if present, include at least SUPPORTED_AUDIO_CHNL_COUNT_1)
                                         *      - 1 Source ASE
                                         *              Audio_Channel_Allocation : Optional (if present, match with Source Audio Locations)
                                         * Optional :
                                         *      - Source Audio Locations
                                         */
#define USR_AUDIO_CONF_3        2       /* Multiple Audio Channels. One bidirectional CIS. Unicast Server is Audio Sink and Audio Source.
                                         * Mandatory :
                                         *      - 1 Sink PAC
                                         *              Supported_Audio_Channel_Counts : Optional (if present, include at least SUPPORTED_AUDIO_CHNL_COUNT_1)
                                         *      - 1 Sink ASE
                                         *              Audio_Channel_Allocation : Optional (if present, match with Sink Audio Locations)
                                         *      - 1 Source PAC
                                         *              Supported_Audio_Channel_Counts : Optional (if present, include at least SUPPORTED_AUDIO_CHNL_COUNT_1)
                                         *      - 1 Source ASE
                                         *              Audio_Channel_Allocation : Optional (if present, match with Source Audio Locations)
                                         * Optional :
                                         *      - Sink Audio Locations
                                         *      - Source Audio Locations
                                         */
#define USR_AUDIO_CONF_4        3       /* Multiple Audio Channels. One unidirectional CIS. Unicast Server is Audio Sink.
                                         * Mandatory :
                                         *      - 1 Sink PAC
                                         *              Supported_Audio_Channel_Counts : Mandatory (if present, include at least SUPPORTED_AUDIO_CHNL_COUNT_2)
                                         *      - 1 Sink ASE
                                         *              Audio_Channel_Allocation : Mandatory (if present, match with two bits set to 0b1 in Sink Audio Locations)
                                         *      - Sink Audio Locations (at least two bits set to 0b1)
                                         */
#define USR_AUDIO_CONF_5        4       /* Multiple Audio Channels. One bidirectional CIS. Unicast Server is Audio Sink and Audio Source.* Mandatory :
                                         * Mandatory :
                                         *      - 1 Sink PAC
                                         *              Supported_Audio_Channel_Counts : Mandatory (if present, include at least SUPPORTED_AUDIO_CHNL_COUNT_2)
                                         *      - 1 Sink ASE
                                         *              Audio_Channel_Allocation : Mandatory (if present, match with two bits set to 0b1 in Sink Audio Locations)
                                         *      - 1 Source PAC
                                         *              Supported_Audio_Channel_Counts : Optional (if present, include at least SUPPORTED_AUDIO_CHNL_COUNT_1)
                                         *      - 1 Source ASE
                                         *              Audio_Channel_Allocation : Optional (if present, match with Source Audio Locations)
                                         *      - Sink Audio Locations (at least two bits set to 0b1)
                                         * Optional :
                                         *      - Source Audio Locations
                                         */
#define USR_AUDIO_CONF_6_I      5       /* Multiple Audio Channels. Two unidirectional CISes. Unicast Server is Audio Sink.
                                         * Mandatory :
                                         *      - 1 Sink PAC
                                         *              Supported_Audio_Channel_Counts : Optional (if present, only SUPPORTED_AUDIO_CHNL_COUNT_1)
                                         *      - 2 Sink ASE
                                         *              Audio_Channel_Allocation : Mandatory.
                                         *              Each ASEs has a different Audio_Channel_Allocation value which match with one of the two bits set to 0b1 in Sink Audio Locations
                                         *      - Sink Audio Locations (at least two bits set to 0b1)
                                         */
#define USR_AUDIO_CONF_6_II     6       /* There is 2 USRs with one Sink ASE per USR with its proper Audio Locations
                                         * Multiple Audio Channels. Two unidirectional CISes. Two Unicast Servers. Unicast Server 1 is Audio Sink. Unicast Server 2 is Audio Sink.
                                         * Mandatory :
                                         *      - 1 Sink PAC
                                         *              Supported_Audio_Channel_Counts : Optional (if present, at least SUPPORTED_AUDIO_CHNL_COUNT_1)
                                         *      - 1 Sink ASE
                                         *              Audio_Channel_Allocation : Mandatory (match with Sink Audio Locations)
                                         *      - Sink Audio Locations (at least 1 bit set to 0b1 but different to the other USR)
                                         */
#define USR_AUDIO_CONF_7_I      7       /* Same as config 3 but on 2 CIS unidirectionnal insteaf of 1 CIS bidirectionnal
                                         * Multiple Audio Channels. Two unidirectional CISes. Unicast Server is Audio Sink and Audio Source.
                                         * Mandatory :
                                         *      - 1 Sink PAC
                                         *              Supported_Audio_Channel_Counts : Optional (if present, include at least SUPPORTED_AUDIO_CHNL_COUNT_1)
                                         *      - 1 Sink ASE
                                         *              Audio_Channel_Allocation : Optional (if present, match with Sink Audio Locations)
                                         *      - 1 Source PAC
                                         *              Supported_Audio_Channel_Counts : Optional (if present, include at least SUPPORTED_AUDIO_CHNL_COUNT_1)
                                         *      - 1 Source ASE
                                         *              Audio_Channel_Allocation : Optional (if present, match with Source Audio Locations)
                                         * Optional :
                                         *      - Sink Audio Locations
                                         *      - Source Audio Locations
                                         */
#define USR_AUDIO_CONF_7_II     8       /* One USR has 1 Snk ASE and the other USR has 1 Src ASE
                                         * Multiple Audio Channels. Two Unidirectional CISes. Two Unicast Servers.
                                         * One USR is similar to Audio Configuration (1)
                                         * One USR is similar to Audio Configuration (2)
                                         */
#define USR_AUDIO_CONF_8_I      9       /* Multiple Audio Channels. One bidirectional CIS and one unidirectional CIS. Unicast Server is Audio Sink and Audio Source.
                                         * Mandatory :
                                         *      - 1 Sink PAC
                                         *              Supported_Audio_Channel_Counts : Optional (if present, include at least SUPPORTED_AUDIO_CHNL_COUNT_1)
                                         *      - 1 Source PAC
                                         *              Supported_Audio_Channel_Counts : Optional (if present, include at least SUPPORTED_AUDIO_CHNL_COUNT_1)
                                         *      - 2 Sink ASE
                                         *              Audio_Channel_Allocation : Mandatory.
                                         *              Each ASEs has a different Audio_Channel_Allocation value which match with one of the two bits set to 0b1 in Sink Audio Locations
                                         *      - 1 Source ASE
                                         *              Audio_Channel_Allocation : Optional (if present, match with Source Audio Locations)
                                         *      - Sink Audio Locations (at least two bits set to 0b1)
                                         * Optional :
                                         *      - Source Audio Locations
                                         */
#define USR_AUDIO_CONF_8_II     10      /* 2 USRs, other USR should have one Snk ASE, with 1 Audio Channel and one Audio locations : At UCL point of view, there is 2 Snk ASE and one Src ASE
                                         * Multiple Audio Channels. One bidirectional CIS and one unidirectional CIS. Two Unicast Servers. Unicast
                                         * Mandatory :
                                         *      - 1 Sink PAC
                                         *              Supported_Audio_Channel_Counts : Optional (if present, include at least SUPPORTED_AUDIO_CHNL_COUNT_1)
                                         *      - 1 Source PAC
                                         *              Supported_Audio_Channel_Counts : Optional (if present, include at least SUPPORTED_AUDIO_CHNL_COUNT_1)
                                         *      - 1 Sink ASE
                                         *              Audio_Channel_Allocation : Mandatory.(match with one bits set to 0b1 in Sink Audio Locations)
                                         *      - 1 Source ASE
                                         *              Audio_Channel_Allocation : Optional (if present, match with Source Audio Locations)
                                         *      - Sink Audio Locations (at least 1 bits set to 0b1 and different to other Sink Audio Locations of 2nd USR)
                                         * Optional :
                                         *      - Source Audio Locations
                                         *
                                         * Note The other USR is similar of the USR in Audio Configuration (6ii)
                                         */
#define USR_AUDIO_CONF_9_I      11      /* Multiple Audio Channels. Two unidirectional CISes. Unicast Server is Audio Source.
                                         * Mandatory :
                                         *      - 1 Source PAC
                                         *              Supported_Audio_Channel_Counts : Optional (if present, only SUPPORTED_AUDIO_CHNL_COUNT_1)
                                         *      - 2 Source ASE
                                         *              Audio_Channel_Allocation : Mandatory.
                                         *              Each ASEs has a different Audio_Channel_Allocation value which match with one of the two bits set to 0b1 in Source Audio Locations
                                         *      - Source Audio Locations (at least two bits set to 0b1)
                                         */
#define USR_AUDIO_CONF_9_II     12      /* There is 2 USRs with one Source ASE per USR with its proper Audio Locations
                                         * Multiple Audio Channels. Two unidirectional CISes. Two Unicast Servers. Unicast Server 1 is Audio Sink. Unicast Source 2 is Audio Source.
                                         * Mandatory :
                                         *      - 1 Source PAC
                                         *              Supported_Audio_Channel_Counts : Optional (if present, at least SUPPORTED_AUDIO_CHNL_COUNT_1)
                                         *      - 1 Source ASE
                                         *              Audio_Channel_Allocation : Mandatory (match with Source Audio Locations)
                                         *      - Source Audio Locations (at least 1 bit set to 0b1 but different to the other USR)
                                         */
#define USR_AUDIO_CONF_10       13      /* Multiple Audio Channels. One unidirectional CIS. Unicast Server is Audio Source.
                                         * Equivalent to Audio Configuration (4) in Source mode
                                         * Mandatory :
                                         *      - 1 Source PAC
                                         *              Supported_Audio_Channel_Counts : Mandatory (if present, include at least SUPPORTED_AUDIO_CHNL_COUNT_2)
                                         *      - 1 Source ASE
                                         *              Audio_Channel_Allocation : Mandatory (if present, match with two bits set to 0b1 in Source Audio Locations)
                                         *      - Source Audio Locations (at least two bits set to 0b1)
                                         */
#define USR_AUDIO_CONF_11_I     14      /* Multiple Audio Channels. Two bidirectional CISes. Unicast Server is Audio Sink and Audio Source
                                         * Mandatory :
                                         *      - 1 Sink PAC
                                         *              Supported_Audio_Channel_Counts : Optional (if present, include at least SUPPORTED_AUDIO_CHNL_COUNT_1)
                                         *      - 1 Source PAC
                                         *              Supported_Audio_Channel_Counts : Optional (if present, include at least SUPPORTED_AUDIO_CHNL_COUNT_1)
                                         *      - 2 Sink ASE
                                         *              Audio_Channel_Allocation : Mandatory.
                                         *              Each ASEs has a different Audio_Channel_Allocation value which match with one bits set to 0b1 in Sink Audio Locations
                                         *      - 2 Source ASE
                                         *              Audio_Channel_Allocation : Mandatory.
                                         *              Each ASEs has a different Audio_Channel_Allocation value which match with one bits set to 0b1 in Source Audio Locations
                                         *      - Sink Audio Locations (at least 2 bits set to 0b1 )
                                         *      - Source Audio Locations (at least 2 bits set to 0b1 )
                                         *
                                         */
#define USR_AUDIO_CONF_11_II    15      /* There is 2 USRs with one Sink ASE per USR with its proper Audio Locations and one Source ASE per USR with its proper Audio Locations
                                         * Multiple Audio Channels. Two bidirectional CISes. Two Unicast Servers.
                                         * Mandatory :
                                         *      - 1 Sink PAC
                                         *              Supported_Audio_Channel_Counts : Optional (if present, include at least SUPPORTED_AUDIO_CHNL_COUNT_1)
                                         *      - 1 Source PAC
                                         *              Supported_Audio_Channel_Counts : Optional (if present, include at least SUPPORTED_AUDIO_CHNL_COUNT_1)
                                         *      - 1 Sink ASE
                                         *              Audio_Channel_Allocation : Mandatory ( match with one bits set to 0b1 in Sink Audio Locations)
                                         *                                         Different to the Audio_Channel_Allocation for the other USR
                                         *      - A Source ASE
                                         *              Audio_Channel_Allocation : Mandatory ( match with one bits set to 0b1 in Source Audio Locations)
                                         *                                         Different to the Audio_Channel_Allocation for the other USR
                                         *      - Sink Audio Locations (at least 1 bits set to 0b1 different to the Sink Audio Locations of the 2nd USR )
                                         *      - Source Audio Locations (at least 1 bits set to 0b1 different to the Source Audio Locations of the 2nd USR )
                                         */
/* Exported types ------------------------------------------------------------*/
/* Audio Profile Link State type */
typedef uint8_t audio_profile_t;
#define AUDIO_PROFILE_NONE                      0x00u
#define AUDIO_PROFILE_UNICAST                   0x01u
#define AUDIO_PROFILE_BA                        0x02u
#define AUDIO_PROFILE_CSIP                      0x04u
#define AUDIO_PROFILE_CCP                       0x08u
#define AUDIO_PROFILE_MCP                       0x10u
#define AUDIO_PROFILE_VCP                       0x20u
#define AUDIO_PROFILE_MICP                      0x40u
#define AUDIO_PROFILE_TMAP                      0x80u

/* CAP Linkup State */
typedef uint8_t APP_CAP_Linkup_State_t;
#define APP_CAP_LINKUP_STATE_NONE               0x00
#define APP_CAP_LINKUP_STATE_STARTED_RESTORE    0x01
#define APP_CAP_LINKUP_STATE_STARTED_COMPLETE   0x02
#define APP_CAP_LINKUP_STATE_DONE_RESTORE       0x03
#define APP_CAP_LINKUP_STATE_DONE_COMPLETE      0x04

/* MCP Client Read State */
typedef uint8_t APP_MCP_Linkup_State_t;
#define APP_MCP_LINKUP_STATE_IDLE                        0x00
#define APP_MCP_LINKUP_STATE_CONFIGURE_TRACK_TITLE_NOTIF 0x01
#define APP_MCP_LINKUP_STATE_READ_MEDIA_STATE            0x02
#define APP_MCP_LINKUP_STATE_READ_TRACK_TITLE            0x03

typedef uint8_t APP_PASyncState_t;
#define APP_PA_SYNC_STATE_IDLE           (0x00)
#define APP_PA_SYNC_STATE_SYNCHRONIZING  (0x01)
#define APP_PA_SYNC_STATE_SYNCHRONIZED   (0x02)

typedef uint8_t APP_BIGSyncState_t;
#define APP_BIG_SYNC_STATE_IDLE          (0x00)
#define APP_BIG_SYNC_STATE_SYNCHRONIZING (0x01)
#define APP_BIG_SYNC_STATE_SYNCHRONIZED  (0x02)

typedef uint8_t APP_ScanState_t;
#define APP_SCAN_STATE_IDLE              (0x00)
#define APP_SCAN_STATE_SCANNING          (0x01)

/* MCP CLient Operation type*/
#define MCP_CLT_OP_CONFIGURE_TRACK_TITLE_NOTIFICATION           0x0001u
#define MCP_CLT_OP_MOVE_NEXT_TRACK                              0x0002u
#define MCP_CLT_OP_MOVE_PREVIOUS_TRACK                          0x0004u
#define MCP_CLT_OP_PLAY_TRACK                                   0x0008u
#define MCP_CLT_OP_PAUSE_TRACK                                  0x0010u
#define MCP_CLT_OP_READ_MEDIA_STATE                             0x0020u
#define MCP_CLT_OP_READ_TRACK_TITLE                             0x0040u
#define MCP_CLT_OP_ALL                                          0x007Fu

/* CCP Client Operation type*/
#define CCP_CLT_OP_READ_CALL_STATE                              0x0100u
#define CCP_CLT_OP_ANSWER_INC_CALL                              0x0200u
#define CCP_CLT_OP_TERMINATE_CALL                               0x0400u
#define CCP_CLT_OP_READ_FEATURES_STATUS                         0x0800u
#define CCP_CLT_OP_ALL                                          0x0F00u

typedef uint8_t APP_BroadcastMode_t;
#define APP_BROADCAST_MODE_NONE                                 (0x00)
#define APP_BROADCAST_MODE_SINK_ONLY                            (0x01)
#define APP_BROADCAST_MODE_SCAN_DELEGATOR                       (0x02)

/*Structure used for ASE information storage*/
typedef struct
{
  uint8_t               ID;
  ASE_State_t           state;
  ASE_Type_t            type;           /*Source of Sink*/
  uint8_t               allocated;
  uint8_t               num_channels;
  uint32_t              presentation_delay;
  uint32_t              controller_delay;
  Audio_Context_t       streaming_audio_context;
  uint8_t               enable_req;
}APP_ASE_Info_t;

typedef struct
{
  uint16_t              acl_conn_handle;
#if (APP_NUM_SNK_ASE > 0)
  APP_ASE_Info_t        aSnkASE[APP_NUM_SNK_ASE];
#endif /* (APP_NUM_SNK_ASE > 0) */
#if (APP_NUM_SRC_ASE > 0)
  APP_ASE_Info_t        aSrcASE[APP_NUM_SRC_ASE];
#endif /* (APP_NUM_SRC_ASE > 0) */
}APP_ASEs_t;

/*Structure used for connection information strorage*/
typedef struct
{
  uint16_t               Acl_Conn_Handle;
  uint8_t                Peer_Address_Type;
  uint8_t                Peer_Address[6];
  uint8_t                Role;
  audio_profile_t        AudioProfile;
  uint8_t                ConfirmIndicationRequired;
  uint8_t                ForceCompleteLinkup;
  uint8_t                LinkupRetry;
  APP_CAP_Linkup_State_t CAPLinkupState;
  uint8_t                GenericMediaPlayerCCID;
  MCP_MediaState_t       MediaState;
  uint8_t                PlayPauseOperation;
  APP_MCP_Linkup_State_t MCPLinkupState;
  uint8_t                GenericTelephoneBearerCCID;
  uint8_t                CurrentCallID;
  CCP_CallState_t        CurrentCallState;
  uint16_t               CurrentContentCtrlOp;
  uint16_t               PendingContentCtrlOp;
  APP_ASEs_t             *pASEs;
  Audio_Context_t        AvailableSnkAudioContext;
  Audio_Context_t        AvailableSrcAudioContext;
}APP_ACL_Conn_t;

#if ((APP_TMAP_ROLE & TMAP_ROLE_BROADCAST_MEDIA_RECEIVER) == TMAP_ROLE_BROADCAST_MEDIA_RECEIVER)
typedef struct
{
  BAP_BASE_Group_t              base_group;
  BAP_BASE_Subgroup_t           base_subgroups[2];
  BAP_BASE_BIS_t                base_bis[2];
  uint8_t                       codec_specific_config_bis[2][MAX_BSNK_BIS_CODEC_CONFIG_SIZE];
  uint8_t                       codec_specific_config_subgroup[2][MAX_BSNK_SUBGROUP_CODEC_CONFIG_SIZE];
  uint8_t                       RTN;
  uint16_t                      max_transport_latency;
  uint8_t                       subgroup_metadata[2][MAX_BSNK_METADATA_LEN];
  Target_Phy_t                  phy;
  uint8_t                       encryption;
  uint32_t                      broadcast_code[4u];
  uint8_t                       audio_driver_config;
  uint16_t                      current_BIS_conn_handles[APP_MAX_NUM_BIS];
  uint8_t                       current_num_bis;
  BAP_AudioCodecController_t    AudioCodecInController;
  BAP_SupportedStandardCodec_t  aStandardCodec[1];
  APP_PASyncState_t             PASyncState;
  APP_BIGSyncState_t            BIGSyncState;
  APP_ScanState_t               ScanState;
  uint8_t                       PASyncHandle;
  Audio_Location_t              Audio_Location;
  uint8_t                       sync_bis_index[APP_MAX_NUM_BIS];
  uint8_t                       num_sync_bis;
} APP_BNSK_Context_t;
#endif /*((APP_TMAP_ROLE & TMAP_ROLE_BROADCAST_MEDIA_RECEIVER) == TMAP_ROLE_BROADCAST_MEDIA_RECEIVER)*/

typedef struct
{
  BAP_Role_t                    bap_role;

  APP_ACL_Conn_t                ACL_Conn[CFG_BLE_NUM_LINK];

  uint8_t                       NumConn;

  uint8_t                       audio_driver_config;

  Audio_Role_t                  audio_role_setup;

  uint16_t                      cis_src_handle[APP_MAX_NUM_CIS];

  uint8_t                       num_cis_src;

  uint16_t                      cis_snk_handle[APP_MAX_NUM_CIS];

  uint8_t                       num_cis_snk;

  uint16_t                      cis_handle[APP_MAX_NUM_CIS];

  uint8_t                       num_cis_established;

  BAP_AudioCodecController_t    AudioCodecInController;

  BAP_SupportedStandardCodec_t  aStandardCodec[1];

  uint8_t                       NumSnkASEs;

  uint8_t                       NumSrcASEs;

  APP_ASEs_t                    aASEs[CFG_BLE_NUM_LINK];

  Audio_Location_t              SnkAudioLocations;

  Audio_Location_t              SrcAudioLocations;

  Audio_Context_t               SupportedSnkAudioContext;

  Audio_Context_t               SupportedSrcAudioContext;

  Audio_Context_t               AvailableSnkAudioContext;

  Audio_Context_t               AvailableSrcAudioContext;

  /* Codec Specific Capabilities for Sink Record */
#if (APP_NUM_SNK_PAC_RECORDS > 0)

  /* Handle of the Sink Audio Codec Record*/
  uint16_t                      aSnkPACRecordHandle[APP_NUM_SNK_PAC_RECORDS];

  /* Sink Published Audio Capabilities Records slots */
  BAP_AudioPACRecord_t          aSnkPACRecord[APP_NUM_SNK_PAC_RECORDS];

  /* Codec Specific Capabilities */
  uint8_t                       aSnkCap[APP_NUM_SNK_PAC_RECORDS][PACS_CODEC_SPECIFIC_CAPABILITIES_LENGTH];

  /* Metadata*/
  uint8_t                       aSnkMetadata[APP_NUM_SNK_PAC_RECORDS][PACS_SRV_METADATA_SIZE];

#endif /*(APP_NUM_SNK_PAC_RECORDS > 0)*/
  /*Codec Specific Capabilities for Source Record*/
#if (APP_NUM_SRC_PAC_RECORDS > 0)

  /*Handle of the Source PAC Record*/
  uint16_t                      aSrcPACRecordHandle[APP_NUM_SRC_PAC_RECORDS];

  /* Source Published Audio Capabilities Records slots*/
  BAP_AudioPACRecord_t          aSrcPACRecord[APP_NUM_SRC_PAC_RECORDS];

  /* Codec Specific Capabilities */
  uint8_t                       aSrcCap[APP_NUM_SRC_PAC_RECORDS][PACS_CODEC_SPECIFIC_CAPABILITIES_LENGTH];

  /* Metadata*/
  uint8_t                       aSrcMetadata[APP_NUM_SRC_PAC_RECORDS][PACS_SRV_METADATA_SIZE];

#endif /*(APP_NUM_SRC_PAC_RECORDS > 0)*/

  uint8_t                       NumOutputChannels;

#if (APP_CSIP_ROLE_SET_MEMBER_SUPPORT)
  uint8_t                       CSIPRank;
#endif /* (APP_CSIP_ROLE_SET_MEMBER_SUPPORT) */

  uint32_t                      Audio_Frequency;
#if ((APP_TMAP_ROLE & TMAP_ROLE_BROADCAST_MEDIA_RECEIVER) == TMAP_ROLE_BROADCAST_MEDIA_RECEIVER)
  APP_BNSK_Context_t            BSNK;
#endif /*((APP_TMAP_ROLE & TMAP_ROLE_BROADCAST_MEDIA_RECEIVER) == TMAP_ROLE_BROADCAST_MEDIA_RECEIVER)*/

} TMAPAPP_Context_t;

typedef struct
{
  Supported_Sampling_Freq_t     Freq;
  Supported_Frame_Duration_t    FrameDuration;
  uint16_t                      MinOctetsPerCodecFrame;
  uint16_t                      MaxOctetsPerCodecFrame;

} APP_CodecCap_t;

typedef struct
{
  Sampling_Freq_t       freq;
  uint32_t              sdu_interval;
  BAP_Framing_t         framing;
  uint16_t              max_sdu;
  uint8_t               rtx_num;
  uint16_t              max_tp_latency;
  uint32_t              presentation_delay;

} APP_QoSConf_t;

typedef struct
{
  uint8_t       NumSnkASEs;
  uint8_t       NumSrcASEs;
  uint8_t       NumAudioChnlsPerSnkASE;
  uint8_t       MinSnkAudioLocations;
  uint8_t       NumAudioChnlsPerSrcASE;
  uint8_t       MinSrcAudioLocations;
  uint8_t       NumCISes;
  uint16_t      NumAudioStreams;

} APP_UnicastAudioConf_t;


/* External variables --------------------------------------------------------*/

/* Exported macros ------------------------------------------------------------*/
/* Exported functions ---------------------------------------------*/
tBleStatus APP_AUDIO_STACK_Init(void);
void TMAPAPP_Init(uint8_t csip_config_id);
tBleStatus TMAPAPP_Linkup(uint16_t ConnHandle);
uint8_t TMAPAPP_StartAdvertising(CAP_Announcement_t AnnouncementType,
                                 uint8_t EnableSolicitationRequest,
                                 uint16_t Appearance);
uint8_t TMAPAPP_StopAdvertising(void);
uint8_t TMAPAPP_VolumeUp(void);
uint8_t TMAPAPP_VolumeDown(void);
uint8_t TMAPAPP_ToggleMute(void);
tBleStatus TMAPAPP_NextTrack(void);
tBleStatus TMAPAPP_PreviousTrack(void);
tBleStatus TMAPAPP_PlayPause(void);
tBleStatus TMAPAPP_AnswerCall(void);
tBleStatus TMAPAPP_TerminateCall(void);
uint8_t TMAPAPP_Disconnect(void);
void TMAPAPP_AclConnected(uint16_t Conn_Handle,uint8_t Peer_Address_Type,uint8_t Peer_Address[6],uint8_t role);
void TMAPAPP_CISConnected(uint16_t Conn_Handle);
void TMAPAPP_LinkDisconnected(uint16_t Conn_Handle,uint8_t Reason);
void TMAPAPP_ConfirmIndicationRequired(uint16_t Conn_Handle);
void TMAPAPP_BondLost(uint16_t Conn_Handle);
#if (APP_CSIP_ROLE_SET_MEMBER_SUPPORT == 1u)
tBleStatus CSIPAPP_RegisterCSIS(uint8_t instance_id,
                                uint8_t SIRK_OOB,
                                uint8_t SIRK_type,
                                uint8_t* SIRK,
                                uint8_t size,
                                uint8_t rank);
#endif /*APP_CSIP_ROLE_SET_MEMBER_SUPPORT == 1u)*/
uint8_t TMAPAPP_SyncToPA(uint8_t AdvSID, uint8_t *pAdvAddress, uint8_t AdvAddressType);
uint8_t TMAPAPP_StartSink(void);
uint8_t TMAPAPP_StopSink(void);
void TMAPAPP_NextSource(void);
void TMAPAPP_SetBroadcastMode(APP_BroadcastMode_t mode);
void TMAPAPP_SwitchLanguage(void);
void TMAPAPP_ClearDatabase(void);
#ifdef __cplusplus
}
#endif

#endif /*__TMAP_APP_H */
