stm32-hotspot/STM32WBA-Advanced-BLE-Broadcast-Speaker/Projects/STM32WBA65I-DK1/Applications/BLE/BLE_Audio_Broadcast_Speaker/Core/Src/app_entry.c

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

/* Includes ------------------------------------------------------------------*/
#include "app_common.h"
#include "log_module.h"
#include "app_conf.h"
#include "main.h"
#include "app_entry.h"
#include "stm32_rtos.h"
#if (CFG_LPM_LEVEL != 0)
#include "stm32_lpm.h"
#endif /* (CFG_LPM_LEVEL != 0) */
#include "stm32_timer.h"
#include "advanced_memory_manager.h"
#include "stm32_mm.h"
#if (CFG_LOG_SUPPORTED != 0)
#include "stm32_adv_trace.h"
#include "serial_cmd_interpreter.h"
#endif /* CFG_LOG_SUPPORTED */
#include "app_ble.h"
#include "ll_sys.h"
#include "ll_sys_if.h"
#include "app_sys.h"
#include "otp.h"
#include "scm.h"
#include "bpka.h"
#include "flash_driver.h"
#include "flash_manager.h"
#include "simple_nvm_arbiter.h"
#include "app_debug.h"

/* USER CODE BEGIN Includes */
#include "app_bsp.h"
#include "codec_mngr.h"
#include "codec_if.h"
#include "stm32wba65i_discovery.h"
#include "stm32wba65i_discovery_audio.h"
#include "stm32wba65i_discovery_bus.h"
#if (CFG_LCD_SUPPORTED == 1)
#include "stm32wba65i_discovery_lcd.h"
#include "stm32_lcd.h"
#endif /* CFG_LCD_SUPPORTED */
#include "stm32_lpm.h"
#include "app_menu.h"
#include "app_menu_cfg.h"

#include "stm32_audio.h"
#include "main_hooks.h"
#if(CFG_RT_DEBUG_DTB == 1)
#include "RTDebug_dtb.h"
#endif /* CFG_RT_DEBUG_DTB */
/* USER CODE END Includes */



/* USER CODE BEGIN PM */
#define VOLUME_VCP_TO_VOLUME_BSP(Volume) ((uint32_t) (280.0f*log10f(((float) Volume)/200.0f + 1.0f)))
/* USER CODE END PM */

#if ( CFG_LPM_LEVEL != 0)
static bool system_startup_done = FALSE;
#endif /* ( CFG_LPM_LEVEL != 0) */

#if (CFG_LOG_SUPPORTED != 0)
/* Log configuration
 * .verbose_level can be any value of the Log_Verbose_Level_t enum.
 * .region_mask can either be :
 * - LOG_REGION_ALL_REGIONS to enable all regions
 * or
 * - One or several specific regions (any value except LOG_REGION_ALL_REGIONS)
 *   from the Log_Region_t enum and matching the mask value.
 *
 *   For example, to enable both LOG_REGION_BLE and LOG_REGION_APP,
 *   the value assigned to the define is :
 *   (1U << LOG_REGION_BLE | 1U << LOG_REGION_APP)
 */
static Log_Module_t Log_Module_Config = { .verbose_level = APPLI_CONFIG_LOG_LEVEL, .region_mask = APPLI_CONFIG_LOG_REGION };
#endif /* (CFG_LOG_SUPPORTED != 0) */

/* AMM configuration */
static uint32_t AMM_Pool[CFG_AMM_POOL_SIZE];
static AMM_VirtualMemoryConfig_t vmConfig[CFG_AMM_VIRTUAL_MEMORY_NUMBER] =
{
  /* Virtual Memory #1 */
  {
    .Id = CFG_AMM_VIRTUAL_STACK_BLE,
    .BufferSize = CFG_AMM_VIRTUAL_STACK_BLE_BUFFER_SIZE
  },
  /* Virtual Memory #2 */
  {
    .Id = CFG_AMM_VIRTUAL_APP_BLE,
    .BufferSize = CFG_AMM_VIRTUAL_APP_BLE_BUFFER_SIZE
  },
};

static AMM_InitParameters_t ammInitConfig =
{
  .p_PoolAddr = AMM_Pool,
  .PoolSize = CFG_AMM_POOL_SIZE,
  .VirtualMemoryNumber = CFG_AMM_VIRTUAL_MEMORY_NUMBER,
  .p_VirtualMemoryConfigList = vmConfig
};

/* USER CODE BEGIN PV */
static uint32_t PLL_Target_Clock_Freq = 0;
static uint8_t MxAudioInit_Flag = 0;
uint32_t Sink_frame_size = 0;
static uint32_t Source_frame_size = 0;
static uint8_t Record_Req_Pause = 0;
static uint8_t Play_Req_Pause = 0;
static uint32_t Current_Volume = 50;
#if (CFG_TEST_VALIDATION == 1u)
JOYPin_TypeDef Joy_PreviousState = JOY_NONE;
#endif /*(CFG_TEST_VALIDATION == 1u)*/

static uint8_t OutITRatio_cnt = 0;
static uint8_t InITRatio_cnt = 0;
static uint8_t ITRatio = 0; /* ratio between LC3 frame duration and AudioChain Frame duration */

static uint16_t *pInLC3data;
static bool InPingPong;

static uint16_t *pOutLC3data;
static bool OutPingPong;
/* USER CODE END PV */

/* Global variables ----------------------------------------------------------*/
/* USER CODE BEGIN GV */
uint32_t gDefault_Exec_Time = 0; /* effective default exec time */
extern TMAPAPP_Context_t TMAPAPP_Context;
int32_t gAudio_Config;

extern uint16_t aLC3InBuff[];
extern uint16_t aSrcBuff[];
extern uint16_t aLC3OutBuff[];
/* USER CODE END GV */

static void System_Init( void );
static void SystemPower_Config( void );
static void Config_HSE(void);
static void APPE_RNG_Init( void );

static void APPE_AMM_Init(void);
static void AMM_WrapperInit(uint32_t * const p_PoolAddr, const uint32_t PoolSize);
static uint32_t * AMM_WrapperAllocate(const uint32_t BufferSize);
static void AMM_WrapperFree(uint32_t * const p_BufferAddr);

static void APPE_FLASH_MANAGER_Init( void );

static void APPE_BPKA_Init( void );

/* USER CODE BEGIN PFP */
static void Init_AudioBuffer(uint8_t *pSnkBuff, uint16_t SnkBuffLen, uint8_t *pSrcBuff, uint16_t SrcBuffLen);
static void AudioClock_Deinit(void);
static void PLL_Ready_Task(void);
static void BSP_MIC_Gain_Init(uint8_t mode);
/* USER CODE END PFP */

/* External variables --------------------------------------------------------*/

/* Functions Definition ------------------------------------------------------*/
/**
 * @brief   Wireless Private Area Network configuration.
 */
void MX_APPE_Config(void)
{
  /* Configure HSE Tuning */
  Config_HSE();
}

/**
 * @brief   Wireless Private Area Network initialisation.
 */
uint32_t MX_APPE_Init(void *p_param)
{
  APP_DEBUG_SIGNAL_SET(APP_APPE_INIT);

  UNUSED(p_param);

  /* System initialization */
  System_Init();

  /* Configure the system Power Mode */
  SystemPower_Config();

  /* Initialize the Advance Memory Manager module */
  APPE_AMM_Init();

  /* Initialize the Random Number Generator module */
  APPE_RNG_Init();

  /* Initialize the Flash Manager module */
  APPE_FLASH_MANAGER_Init();

  /* USER CODE BEGIN APPE_Init_1 */
  APP_BSP_Init();

#if (CFG_LCD_SUPPORTED == 1)
  UTIL_SEQ_RegTask(1U << CFG_TASK_MENU_PRINT_ID, UTIL_SEQ_RFU, Menu_Print_Task);
#endif /* CFG_LCD_SUPPORTED */

  UTIL_SEQ_RegTask(1U << CFG_TASK_PLL_READY_ID, UTIL_SEQ_RFU, PLL_Ready_Task);
  /* USER CODE END APPE_Init_1 */

  /* Initialize the Ble Public Key Accelerator module */
  APPE_BPKA_Init();

  /* Initialize the Simple Non Volatile Memory Arbiter */
  if( SNVMA_Init((uint32_t *)CFG_SNVMA_START_ADDRESS) != SNVMA_ERROR_OK )
  {
    Error_Handler();
  }

  APP_BLE_Init();

  /* Disable RFTS Bypass for flash operation - Since LL has not started yet */
  FD_SetStatus (FD_FLASHACCESS_RFTS_BYPASS, LL_FLASH_DISABLE);

  /* USER CODE BEGIN APPE_Init_2 */
  /* Indicate to the low power manager that the Standby mode isn't allow : Stop mode will be used in low power mode*/
  UTIL_LPM_SetOffMode(1U << CFG_LPM_APP, UTIL_LPM_DISABLE);

  /* USER CODE END APPE_Init_2 */

  APP_DEBUG_SIGNAL_RESET(APP_APPE_INIT);

  return WPAN_SUCCESS;
}

void MX_APPE_Process(void)
{
  UTIL_SEQ_Run(UTIL_SEQ_DEFAULT);
}

/*************************************************************
 *
 * LOCAL FUNCTIONS
 *
 *************************************************************/

/**
 * @brief Configure HSE by read this Tuning from OTP
 *
 */
static void Config_HSE(void)
{
  OTP_Data_s* otp_ptr = NULL;

  /* Read HSE_Tuning from OTP */
  if (OTP_Read(DEFAULT_OTP_IDX, &otp_ptr) != HAL_OK)
  {
    /* OTP no present in flash, apply default gain */
    HAL_RCCEx_HSESetTrimming(0x0C);
  }
  else
  {
    HAL_RCCEx_HSESetTrimming(otp_ptr->hsetune);
  }
}

/**
 *
 */
static void System_Init( void )
{
  /* Clear RCC RESET flag */
  LL_RCC_ClearResetFlags();

  /* Initialize the Timer Server */
  UTIL_TIMER_Init();

  /* Enable wakeup out of standby from RTC ( UTIL_TIMER )*/
  HAL_PWR_EnableWakeUpPin(PWR_WAKEUP_PIN7_HIGH_3);

#if (CFG_LOG_SUPPORTED != 0)
  MX_USART1_UART_Init();

  /* Initialize the logs ( using the USART ) */
  Log_Module_Init( Log_Module_Config );

  /* Initialize the Command Interpreter */
  Serial_CMD_Interpreter_Init();
#endif  /* (CFG_LOG_SUPPORTED != 0) */

#if(CFG_RT_DEBUG_DTB == 1)
  /* DTB initialization and configuration */
  RT_DEBUG_DTBInit();
  RT_DEBUG_DTBConfig();
#endif /* CFG_RT_DEBUG_DTB */
#if(CFG_RT_DEBUG_GPIO_MODULE == 1)
  /* RT DEBUG GPIO_Init */
  RT_DEBUG_GPIO_Init();
#endif /* (CFG_RT_DEBUG_GPIO_MODULE == 1) */

#if ( CFG_LPM_LEVEL != 0)
  system_startup_done = TRUE;
  UNUSED(system_startup_done);
#endif /* ( CFG_LPM_LEVEL != 0) */

  return;
}

/**
 * @brief  Configure the system for power optimization
 *
 * @note  This API configures the system to be ready for low power mode
 *
 * @param  None
 * @retval None
 */
static void SystemPower_Config(void)
{
#if (CFG_SCM_SUPPORTED == 1)
  /* Initialize System Clock Manager */
  scm_init();
#endif /* CFG_SCM_SUPPORTED */

#if (CFG_DEBUGGER_LEVEL == 0)
  /* Setup GPIOA 13, 14, 15 in Analog no pull */
  if(__HAL_RCC_GPIOA_IS_CLK_ENABLED() == 0)
  {
    __HAL_RCC_GPIOA_CLK_ENABLE();
    GPIOA->PUPDR &= ~0xFC000000;
    GPIOA->MODER |= 0xFC000000;
    __HAL_RCC_GPIOA_CLK_DISABLE();
  }
  else
  {
    GPIOA->PUPDR &= ~0xFC000000;
    GPIOA->MODER |= 0xFC000000;
  }

  /* Setup GPIOB 3, 4 in Analog no pull */
  if(__HAL_RCC_GPIOB_IS_CLK_ENABLED() == 0)
  {
    __HAL_RCC_GPIOB_CLK_ENABLE();
    GPIOB->PUPDR &= ~0x3C0;
    GPIOB->MODER |= 0x3C0;
    __HAL_RCC_GPIOB_CLK_DISABLE();
  }
  else
  {
    GPIOB->PUPDR &= ~0x3C0;
    GPIOB->MODER |= 0x3C0;
  }
#endif /* CFG_DEBUGGER_LEVEL */

#if (CFG_LPM_LEVEL != 0)
  /* Initialize low Power Manager. By default enabled */
  UTIL_LPM_Init();

#if (CFG_LPM_STDBY_SUPPORTED > 0)
  /* Enable SRAM1, SRAM2 and RADIO retention*/
  LL_PWR_SetSRAM1SBRetention(LL_PWR_SRAM1_SB_FULL_RETENTION);
  LL_PWR_SetSRAM2SBRetention(LL_PWR_SRAM2_SB_FULL_RETENTION);
  LL_PWR_SetRadioSBRetention(LL_PWR_RADIO_SB_FULL_RETENTION); /* Retain sleep timer configuration */

#else /* (CFG_LPM_STDBY_SUPPORTED > 0) */
  UTIL_LPM_SetOffMode(1U << CFG_LPM_APP, UTIL_LPM_DISABLE);
#endif /* (CFG_LPM_STDBY_SUPPORTED > 0) */
#endif /* (CFG_LPM_LEVEL != 0)  */

}

/**
 * @brief Initialize Random Number Generator module
 */
static void APPE_RNG_Init(void)
{
  HW_RNG_SetPoolThreshold(CFG_HW_RNG_POOL_THRESHOLD);
  HW_RNG_Init();
  HW_RNG_Start();

  /* Register Random Number Generator task */
  UTIL_SEQ_RegTask(1U << CFG_TASK_HW_RNG, UTIL_SEQ_RFU, (void (*)(void))HW_RNG_Process);
}

/**
 * @brief Initialize Flash Manager module
 */
static void APPE_FLASH_MANAGER_Init(void)
{
  /* Register Flash Manager task */
  UTIL_SEQ_RegTask(1U << CFG_TASK_FLASH_MANAGER, UTIL_SEQ_RFU, FM_BackgroundProcess);

  /* Disable flash before any use - RFTS */
  FD_SetStatus (FD_FLASHACCESS_RFTS, LL_FLASH_DISABLE);
  /* Enable RFTS Bypass for flash operation - Since LL has not started yet */
  FD_SetStatus (FD_FLASHACCESS_RFTS_BYPASS, LL_FLASH_ENABLE);
  /* Enable flash system flag */
  FD_SetStatus (FD_FLASHACCESS_SYSTEM, LL_FLASH_ENABLE);

  return;
}

/**
 * @brief Initialize Ble Public Key Accelerator module
 */
static void APPE_BPKA_Init(void)
{
  /* Register Ble Public Key Accelerator task */
  UTIL_SEQ_RegTask(1U << CFG_TASK_BPKA, UTIL_SEQ_RFU, BPKA_BG_Process);
}

static void APPE_AMM_Init(void)
{
  /* Initialize the Advance Memory Manager */
  if( AMM_Init(&ammInitConfig) != AMM_ERROR_OK )
  {
    Error_Handler();
  }

  /* Register Advance Memory Manager task */
  UTIL_SEQ_RegTask(1U << CFG_TASK_AMM, UTIL_SEQ_RFU, AMM_BackgroundProcess);
}

/* USER CODE BEGIN FD_LOCAL_FUNCTIONS */
#if (CFG_JOYSTICK_SUPPORTED == 1)
/**
 * @brief  Action of Joystick NONE when Joystick state changes to None state, to be implemented by user.
 * @param  None
 * @retval None
 */
void APP_BSP_JoystickNoneAction( void )
{
#if (CFG_TEST_VALIDATION == 1u)
  LOG_INFO_APP("JOY_NONE\n");
  Joy_PreviousState = JOY_NONE;
#endif /*(CFG_TEST_VALIDATION == 1u)*/
}
/**
 * @brief  Action of Joystick UP when pressed, to be implemented by user.
 * @param  None
 * @retval None
 */
void APP_BSP_JoystickUpAction( void )
{
#if (CFG_TEST_VALIDATION == 1u)
  if (Joy_PreviousState == JOY_NONE)
  {
    LOG_INFO_APP("JOY 0x%02X\nOK\n",JOY_UP);
    Joy_PreviousState = JOY_UP;
#endif /*(CFG_TEST_VALIDATION == 1u)*/

    Menu_Up();

#if (CFG_TEST_VALIDATION == 1u)
  }
#endif /*(CFG_TEST_VALIDATION == 1u)*/
}

/**
 * @brief  Action of Joystick RIGHT when pressed, to be implemented by user.
 * @param  None
 * @retval None
 */
void APP_BSP_JoystickRightAction( void )
{
#if (CFG_TEST_VALIDATION == 1u)
  if (Joy_PreviousState == JOY_NONE)
  {
    LOG_INFO_APP("JOY 0x%02X\nOK\n",JOY_RIGHT);
    Joy_PreviousState = JOY_RIGHT;
#endif /*(CFG_TEST_VALIDATION == 1u)*/

    Menu_Right();

#if (CFG_TEST_VALIDATION == 1u)
  }
#endif /*(CFG_TEST_VALIDATION == 1u)*/
}

/**
 * @brief  Action of Joystick DOWN when pressed, to be implemented by user.
 * @param  None
 * @retval None
 */
void APP_BSP_JoystickDownAction( void )
{
#if (CFG_TEST_VALIDATION == 1u)
  if (Joy_PreviousState == JOY_NONE)
  {
    LOG_INFO_APP("JOY 0x%02X\nOK\n",JOY_DOWN);
    Joy_PreviousState = JOY_DOWN;
#endif /*(CFG_TEST_VALIDATION == 1u)*/

    Menu_Down();

#if (CFG_TEST_VALIDATION == 1u)
  }
#endif /*(CFG_TEST_VALIDATION == 1u)*/
}

/**
 * @brief  Action of Joystick LEFT when pressed, to be implemented by user.
 * @param  None
 * @retval None
 */
void APP_BSP_JoystickLeftAction( void )
{
#if (CFG_TEST_VALIDATION == 1u)
  if (Joy_PreviousState == JOY_NONE)
  {
    LOG_INFO_APP("JOY 0x%02X\nOK\n",JOY_LEFT);
    Joy_PreviousState = JOY_LEFT;
#endif /*(CFG_TEST_VALIDATION == 1u)*/

    Menu_Left();

#if (CFG_TEST_VALIDATION == 1u)
  }
#endif /*(CFG_TEST_VALIDATION == 1u)*/
}

/**
 * @brief  Action of Joystick SELECT when pressed, to be implemented by user.
 * @param  None
 * @retval None
 */
void APP_BSP_JoystickSelectAction( void )
{
#if (CFG_TEST_VALIDATION == 1u)
  if (Joy_PreviousState == JOY_NONE)
  {
    LOG_INFO_APP("JOY 0x%02X\nOK\n",JOY_SEL);
    Joy_PreviousState = JOY_SEL;
#endif /*(CFG_TEST_VALIDATION == 1u)*/
#if (CFG_TEST_VALIDATION == 1u)
  }
#endif /*(CFG_TEST_VALIDATION == 1u)*/
}

#endif  /* CFG_JOYSTICK_SUPPORTED */

/**
  * @brief Configure PLL for the audio frequency, PLL output is used for the SAI peripheral and as the core clock
  * @retval None
  */
void AudioClock_Init(uint32_t audio_frequency_type)
{
  uint32_t target_freq;
  if (audio_frequency_type == SAMPLE_FREQ_44100_HZ)
  {
    target_freq = 90316800;
  }
  else
  {
    /* valid for 8k, 16k, 24k, 32k or 48k */
    target_freq = 98304000;
  }

  if ( target_freq !=  PLL_Target_Clock_Freq )
  {
    scm_pll_config_t pll_config;
    LOG_INFO_APP("Audio Clock Initialization\n");

    pll_config.pll_mode = PLL_FRACTIONAL_MODE;
    pll_config.PLLM = 6;
    pll_config.PLLP = 4;
    pll_config.PLLQ = 4;
    pll_config.PLLR = 4;

    /* VCO frequency should be in range 128 to 544 MHz */
    /* PLL fractionnal should allows to cover +/-550ppm around the targeted frequency*/
    if (target_freq == 90316800)
    {
      pll_config.PLLN = 67;  /* VCO = HSE/M * N * (1 + Nfrac / 8192) < 32 / 6 * (67 + 1) = 362.7 MHz */
      pll_config.PLLFractional = 6042;
      pll_config.AHB5_PLL1_CLKDivider = LL_RCC_AHB5_DIV_3;
      /* PLLSYS = 90.31673 MHz */
    }
    else
    {
      pll_config.PLLN = 73;  /* VCO = HSE/M * N * (1 + Nfrac / 8192) < 32 / 6 * (73 + 1) = 394.7 MHz */
      pll_config.PLLFractional = 5964;
      pll_config.AHB5_PLL1_CLKDivider = LL_RCC_AHB5_DIV_4;
      /* PLLSYS = 98.30396 MHz */
    }

    UTIL_LPM_SetStopMode(1 << CFG_LPM_AUDIO, UTIL_LPM_DISABLE);

    scm_pll_setconfig(&pll_config);

    scm_setsystemclock(SCM_USER_APP, SYS_PLL);

    /* enable P output used for the audio timer */
    LL_RCC_PLL1_EnableDomain_PLL1P();

    PLL_Target_Clock_Freq = target_freq;
  }
  else
  {
    LOG_INFO_APP("Audio Clock already configured\n");
  }
}

void PLL_Ready_ProcessIT(void)
{
  UTIL_SEQ_SetTask(1U << CFG_TASK_PLL_READY_ID, CFG_SEQ_PRIO_0);
}

void PLL_Ready_Task(void)
{
  /* set Link Layer audio timings */
  uint32_t iso_exec_time;
  Evnt_timing_t event_time;
  event_time.drift_time    = ISO_PLL_DRIFT_TIME;
  event_time.exec_time     = ISO_PLL_EXEC_TIME;
  event_time.schdling_time = ISO_PLL_SCHDL_TIME;

#if defined(__GNUC__) && defined(DEBUG)
  event_time.drift_time += ISO_PLL_DRIFT_TIME_EXTRA_GCC_DEBUG;
  event_time.exec_time += ISO_PLL_EXEC_TIME_EXTRA_GCC_DEBUG;
#endif

  ll_intf_config_schdling_time(&event_time, &iso_exec_time);

  CODEC_CLK_Init();

  AUDIO_PLLConfig_t corrector_pll_config;
  corrector_pll_config.PLLTargetFreq = PLL_Target_Clock_Freq;
  corrector_pll_config.VCOInputFreq = (32000000.0f / 6.0f); /* HSE / PLL_M */
  corrector_pll_config.PLLOutputDiv = 4; /* PLL_P */
  AUDIO_InitializeClockCorrector(&corrector_pll_config, 500, 4000);

  /* I2C init takes a long time, it is better to do it before CIS establishement */
  BSP_I2C1_Init();
}

void PLL_Exit(void)
{
  if (PLL_Target_Clock_Freq != 0)
  {
    scm_setsystemclock(SCM_USER_APP, NO_CLOCK_CONFIG);

    PLL_Target_Clock_Freq = 0;

    UTIL_LPM_SetStopMode(1 << CFG_LPM_AUDIO, UTIL_LPM_ENABLE);
  }
}


static void AudioClock_Deinit( void )
{
  /* back to default timings */
  Evnt_timing_t event_time;
  event_time.drift_time    = DRIFT_TIME_DEFAULT;
  event_time.exec_time     = EXEC_TIME_DEFAULT;
  event_time.schdling_time = SCHDL_TIME_DEFAULT;

#if defined(__GNUC__) && defined(DEBUG)
  event_time.drift_time += DRIFT_TIME_EXTRA_GCC_DEBUG;
  event_time.exec_time += EXEC_TIME_EXTRA_GCC_DEBUG;
#endif

  ll_intf_config_schdling_time(&event_time, &gDefault_Exec_Time);

  LOG_INFO_APP("Audio Clock Deinitialization\n");

  AUDIO_DeinitializeClockCorrector();
}

HAL_StatusTypeDef MX_SAI1_ClockConfig(SAI_HandleTypeDef *hsai, uint32_t SampleRate)
{
  /* PLL already configured */

  RCC_PeriphCLKInitTypeDef PeriphClkInit = {0};

  PeriphClkInit.PeriphClockSelection = RCC_PERIPHCLK_SAI1;
  PeriphClkInit.Sai1ClockSelection = RCC_SAI1CLKSOURCE_PLL1P;
  if (HAL_RCCEx_PeriphCLKConfig(&PeriphClkInit) != HAL_OK)
  {
    Error_Handler();
  }

  __HAL_RCC_SAI1_CLK_ENABLE();

  return HAL_OK;
}

/**
  * @brief Adjust microphone gain using 3 pre-set configuration
  * @note  To be used at the initialization only, after BSP_AUDIO_xx_Init()
  * @param mode : value from 0 to 2, 0 for lowest gain and 2 for the highest
  */
static void BSP_MIC_Gain_Init(const uint8_t mode)
{
  const uint16_t Tab_vol_left[3] = {0x01A8, 0x01C0, 0x01FF};

  if( mode > 2)
  {
    Error_Handler();
  }
  else
  {
    uint8_t tmp[2];

    tmp[0] = (uint8_t)(Tab_vol_left[mode] >> 8);
    tmp[1] = (uint8_t)(Tab_vol_left[mode]);

    BSP_I2C1_WriteReg(AUDIO_I2C_ADDRESS, WM8904_ADC_DIGITAL_VOL_LEFT, tmp, 0x02);
  }
}

void MX_AudioInit(Audio_Role_t role,
                  Sampling_Freq_t sampling_frequency,
                  Frame_Duration_t frame_duration,
                  uint8_t *pSnkBuff,
                  uint8_t *pSrcBuff)
{
  uint32_t sample_per_frame;
  uint32_t audioFrequency;
  uint32_t channel_at_src;
  BSP_AUDIO_Init_t audio_conf;

  switch (sampling_frequency)
  {
    case SAMPLE_FREQ_8000_HZ:
      audioFrequency = SAI_AUDIO_FREQUENCY_8K;
      if (pSrcBuff == NULL)
        gAudio_Config = audio_persist_get_config_index_from_name("media8kHz");
      else
        gAudio_Config = audio_persist_get_config_index_from_name("telephony8kHz");
      break;

    case SAMPLE_FREQ_16000_HZ:
      audioFrequency = SAI_AUDIO_FREQUENCY_16K;
      if (pSrcBuff == NULL)
        gAudio_Config = audio_persist_get_config_index_from_name("media16kHz");
      else
        gAudio_Config = audio_persist_get_config_index_from_name("telephony16kHz");
      break;

    case SAMPLE_FREQ_24000_HZ:
      audioFrequency = SAI_AUDIO_FREQUENCY_24K;
      if (pSrcBuff == NULL)
        gAudio_Config = audio_persist_get_config_index_from_name("media24kHz");
      else
        gAudio_Config = audio_persist_get_config_index_from_name("telephony24kHz");
      break;

    case SAMPLE_FREQ_32000_HZ:
      audioFrequency = SAI_AUDIO_FREQUENCY_32K;
      if (pSrcBuff == NULL)
        gAudio_Config = audio_persist_get_config_index_from_name("media32kHz");
      else
        gAudio_Config = audio_persist_get_config_index_from_name("telephony32kHz");
      break;

    case SAMPLE_FREQ_48000_HZ:
      audioFrequency = SAI_AUDIO_FREQUENCY_48K;
      if (pSrcBuff == NULL)
        gAudio_Config = audio_persist_get_config_index_from_name("media48kHz");
      else
        Error_Handler(); // telephony at 48Khz not supported
      break;

    default:
      Error_Handler();
      return;
  }

  if (sampling_frequency == SAMPLE_FREQ_44100_HZ)
  {
    /* LC3 need setup like 48Khz for this frequency */
    sampling_frequency = SAMPLE_FREQ_48000_HZ;
  }

	switch(frame_duration)
	{
      case FRAME_DURATION_7_5_MS:
        sample_per_frame = audioFrequency * 75 / 10000;
        Error_Handler(); /* not supported in this demo */
        break;

      case FRAME_DURATION_10_MS:
        /* sample per LC3 frame, may be devided later if UTIL_AUDIO_N_MS_PER_INTERRUPT is not 10ms */
        sample_per_frame = audioFrequency * 100 / 10000;
        if (10 % UTIL_AUDIO_N_MS_PER_INTERRUPT != 0)
        {
          Error_Handler();
        }
        ITRatio = 10 / UTIL_AUDIO_N_MS_PER_INTERRUPT;
        OutITRatio_cnt = 0;
        InITRatio_cnt = 0;
        break;

      default:
        Error_Handler();
        return;
	}


  __HAL_RCC_I2C1_CLK_ENABLE();

  audio_conf.Device = AUDIO_IN_DEVICE_ANALOG_MIC;
  audio_conf.ChannelsNbr = 1;
  channel_at_src = 1;

  audio_conf.Volume = Current_Volume; /* input volume is not used */
  audio_conf.SampleRate = audioFrequency;
  audio_conf.BitsPerSample = AUDIO_RESOLUTION_16B;

  if (BSP_AUDIO_IN_Init(0x00, &audio_conf) != BSP_ERROR_NONE)
  {
    Error_Handler();
    /* Release Bus for power consumption optimisation */
    __HAL_RCC_I2C1_CLK_DISABLE();
    return;
  }

  audio_conf.Device = AUDIO_OUT_DEVICE_HEADPHONE;
  audio_conf.ChannelsNbr = (pSrcBuff == NULL)? 2 : 1; /* when duplex, we use mono */
  audio_conf.Volume = Current_Volume;
  if (BSP_AUDIO_OUT_Init(0x00, &audio_conf) != BSP_ERROR_NONE)
  {
    Error_Handler();
    /* Release Bus for power consumption optimisation */
    __HAL_RCC_I2C1_CLK_DISABLE();
    return;
  }

  BSP_MIC_Gain_Init(MIC_GAIN_CONFIG);
  BSP_AUDIO_OUT_SetVolume(0, Current_Volume);

  /* Start SAI clock without DMA interrupt */
  uint8_t channel_at_snk = (pSrcBuff == NULL)? 2 : 1;   /* SAI is in stereo for Headset */
  uint8_t buffer_nb = 2;        /* double buffer strategy for minimum latency*/
  uint8_t bytes_per_sample = 2;

  /* init may depend on the audio frequency (takes less than 100ms) */
  main_hooks_audioInit();
  /* we don't use stm32_audio.c for init the BSP (callback not registered), only for buffer allocation */
  UTIL_AUDIO_init((pSrcBuff == NULL)? 0 : 1);
  UTIL_AUDIO_start();

  Sink_frame_size = (sample_per_frame * channel_at_snk * buffer_nb) / ITRatio;
  Source_frame_size = (sample_per_frame * channel_at_src * buffer_nb) / ITRatio;
  /* Start SAI clock without DMA interrupt */
  Init_AudioBuffer((uint8_t *)pSnkBuff,
                   Sink_frame_size * bytes_per_sample,
                   (uint8_t *)pSrcBuff,
                   Source_frame_size * bytes_per_sample);

  /* Release Bus for power consumption optimisation */
  __HAL_RCC_I2C1_CLK_DISABLE();
  MxAudioInit_Flag = 1;
}

void MX_AudioDeInit(void)
{
  if (MxAudioInit_Flag == 1)
  {
    MxAudioInit_Flag = 0;

    __HAL_RCC_I2C1_CLK_ENABLE();

    if (BSP_AUDIO_IN_DeInit(0x00) != BSP_ERROR_NONE)
    {
      Error_Handler();
    }

    if (BSP_AUDIO_OUT_DeInit(0x00) != BSP_ERROR_NONE)
    {
      Error_Handler();
    }

    BSP_I2C1_DeInit();
    SET_BIT(haudio_in_sai.Instance->CR2, SAI_xCR2_FFLUSH);
    SET_BIT(haudio_out_sai.Instance->CR2, SAI_xCR2_FFLUSH);

    UTIL_AUDIO_stop();
    UTIL_AUDIO_deinit();
    main_hooks_audioDeInit();

    UTIL_AUDIO_RENDER_clearBuffer();

    /* Clear Capture scratch buffer */
    memset(aLC3OutBuff, 0, Sink_frame_size*ITRatio*sizeof(uint16_t));

    memset(aSrcBuff, 0, Source_frame_size*sizeof(uint16_t));

  }

  AudioClock_Deinit();
}

static void Init_AudioBuffer(uint8_t *pSnkBuff, uint16_t SnkBuffLen, uint8_t *pSrcBuff, uint16_t SrcBuffLen)
{
  /* We start the SAI here but will pause the DMA on the first interrupt.
     The DMA will be relauched synchronized to the BLE transport for mastering audio latency */
  if ((SnkBuffLen  > 0) && (pSnkBuff != NULL))
  {
    if (BSP_AUDIO_OUT_Play(0, (uint8_t *)pSnkBuff, SnkBuffLen) != BSP_ERROR_NONE)
    {
      Error_Handler();
    }
    Play_Req_Pause = 1;
  }
  if ((SrcBuffLen  > 0) && (pSrcBuff != NULL))
  {
    if (BSP_AUDIO_IN_Record(0, (uint8_t *)pSrcBuff, SrcBuffLen) != BSP_ERROR_NONE)
    {
      Error_Handler();
    }
    Record_Req_Pause = 1;
  }
}

int32_t Start_TxAudio(void)
{
  int32_t status = 1;

  /* restart DMA request only if it was on pause */
  if ((haudio_out_sai.Instance->CR1 & SAI_xCR1_DMAEN) == 0)
  {
    SET_BIT(haudio_out_sai.Instance->CR2, SAI_xCR2_FFLUSH);
    haudio_out_sai.Instance->CR1 |= SAI_xCR1_DMAEN;
    status = 0;

    OutPingPong = 0;
    pOutLC3data = &aLC3OutBuff[Sink_frame_size*ITRatio/2];
    BSP_AUDIO_OUT_TransferComplete_CallBack(0);
  }

  return status;
}

void Stop_TxAudio(void)
{
  /* Initialize Bus which bas been released for Power consumption optimisation */
 __HAL_RCC_I2C1_CLK_ENABLE();

  if (BSP_AUDIO_OUT_Stop(0) != BSP_ERROR_NONE)
  {
    Error_Handler();
  }

  /* Release Bus for power consumption optimisation */
  __HAL_RCC_I2C1_CLK_DISABLE();
}

static void App_AudioKit_OutProcessMngr(void)
{
  /* copy data to audio kit in */
  UTIL_AUDIO_CAPTURE_TxComplete_cb((pOutLC3data-&aLC3OutBuff[0])*sizeof(uint16_t), MAIN_PATH);

  pOutLC3data += Sink_frame_size/2;
  if (pOutLC3data == &aLC3OutBuff[Sink_frame_size*ITRatio])
  {
    pOutLC3data = &aLC3OutBuff[0]; //loop
  }

  /* trigger of LC3 processing */
  if (OutITRatio_cnt == 0)
  {
    if (OutPingPong)
      APP_NotifyTxAudioCplt(ITRatio*Sink_frame_size);
    else
      APP_NotifyTxAudioHalfCplt();

    OutPingPong ^= 1;
  }

  OutITRatio_cnt++;
  OutITRatio_cnt = OutITRatio_cnt%ITRatio;

  /* trigger of audiokit processing */
  UTIL_AUDIO_process();
}


void BSP_AUDIO_OUT_TransferComplete_CallBack(uint32_t instance)
{

  /* provide ptr to audio kit output to peripheral */
  UTIL_AUDIO_RENDER_TxComplete_cb(UTIL_AUDIO_RENDER_getHalfAddr(MAIN_PATH), MAIN_PATH);

  App_AudioKit_OutProcessMngr();
}

void BSP_AUDIO_OUT_HalfTransfer_CallBack(uint32_t instance)
{
  if (MxAudioInit_Flag == 1)
  {
    if (Play_Req_Pause == 1)
    {
      /* Pause the DMA aligned on a interrupt and wait the codec trigger to restart it synchronized to BLE */
      haudio_out_sai.Instance->CR1 &= ~SAI_xCR1_DMAEN;

      Play_Req_Pause = 0;
    }
    else
    {
      /* provide ptr to audio kit output to peripheral */
      UTIL_AUDIO_RENDER_TxComplete_cb(UTIL_AUDIO_RENDER_getBaseAddr(MAIN_PATH), MAIN_PATH);

      App_AudioKit_OutProcessMngr();
    }
  }
}

int32_t Start_RxAudio(void)
{
  int32_t status = 1;

  /* restart DMA request only if it was on pause */
  if ((haudio_in_sai.Instance->CR1 & SAI_xCR1_DMAEN) == 0)
  {
    SET_BIT(haudio_in_sai.Instance->CR2, SAI_xCR2_FFLUSH);
    haudio_in_sai.Instance->CR1 |= SAI_xCR1_DMAEN;
    status = 0;
  }

  InPingPong = 0;
  pInLC3data = aLC3InBuff;
  return status;
}

void Stop_RxAudio(void)
{
  /* Initialize Bus which bas been released for Power consumption optimisation */
  __HAL_RCC_I2C1_CLK_ENABLE();

  if (BSP_AUDIO_IN_Stop(0) != BSP_ERROR_NONE)
  {
    Error_Handler();
  }

  /* Release Bus for power consumption optimisation */
  __HAL_RCC_I2C1_CLK_DISABLE();
}

static void App_AudioKit_INPreparation(void)
{
  /* provide ptr to audio kit output to BLE LC3 IN buffer */
  /* the processing at In is aligned on DMA out interrupt in this project, so we have to delay one more DMA frame */
  UTIL_AUDIO_RENDER_TxComplete_cb(pInLC3data, ALTERNATE_PATH);


  pInLC3data += Source_frame_size/2; //add size of a half DMA frame
  if (pInLC3data == &aLC3InBuff[Source_frame_size*ITRatio])
  {
    pInLC3data = &aLC3InBuff[0]; //loop
  }

  InITRatio_cnt++;
  InITRatio_cnt = InITRatio_cnt%ITRatio;

  /* trigger of LC3 encoding */
  if (InITRatio_cnt == 0)
  {
    if (InPingPong)
      APP_NotifyRxAudioHalfCplt(); // first buffer
    else
      APP_NotifyRxAudioCplt(Source_frame_size*ITRatio); // second buffer

    InPingPong ^= 1; // toogle ping pong
  }
}


void BSP_AUDIO_IN_TransferComplete_CallBack(uint32_t instance)
{
  App_AudioKit_INPreparation();

  /* copy from SAI input to audiokit in */
  UTIL_AUDIO_CAPTURE_TxComplete_cb(Source_frame_size, ALTERNATE_PATH);
}

void BSP_AUDIO_IN_HalfTransfer_CallBack(uint32_t instance)
{
  if (MxAudioInit_Flag == 1)
  {
    if (Record_Req_Pause == 1)
    {
      /* Pause the DMA aligned on a interrupt and wait the codec trigger to restart it synchronized to BLE */
      haudio_in_sai.Instance->CR1 &= ~SAI_xCR1_DMAEN;

      Record_Req_Pause = 0;
    }
    else
    {
      App_AudioKit_INPreparation();

      /* copy from SAI input to audiokit in */
      UTIL_AUDIO_CAPTURE_TxComplete_cb(0, ALTERNATE_PATH);
    }
  }
}

void Set_Volume(uint8_t Volume)
{
  Current_Volume = VOLUME_VCP_TO_VOLUME_BSP(Volume);

  __HAL_RCC_I2C1_CLK_ENABLE();
  BSP_AUDIO_OUT_SetVolume(0, Current_Volume);
  __HAL_RCC_I2C1_CLK_DISABLE();
}
/* USER CODE END FD_LOCAL_FUNCTIONS */

/*************************************************************
 *
 * WRAP FUNCTIONS
 *
 *************************************************************/

void UTIL_SEQ_Idle( void )
{
#if ( CFG_LPM_LEVEL != 0)
  HAL_SuspendTick();
#if (CFG_SCM_SUPPORTED == 1)
  /* SCM HSE BEGIN */
  SCM_HSE_StopStabilizationTimer();
  /* SCM HSE END */
#endif /* CFG_SCM_SUPPORTED */
  UTIL_LPM_EnterLowPower();
  HAL_ResumeTick();
#endif /* CFG_LPM_LEVEL */
  return;
}

void UTIL_SEQ_PreIdle( void )
{
#if ( CFG_LPM_LEVEL != 0)
  LL_PWR_ClearFlag_STOP();

  if ( ( system_startup_done != FALSE ) && ( UTIL_LPM_GetMode() == UTIL_LPM_OFFMODE ) )
  {
    APP_SYS_BLE_EnterDeepSleep();
  }

  LL_RCC_ClearResetFlags();

#if defined(STM32WBAXX_SI_CUT1_0)
  /* Wait until HSE is ready */
#if (CFG_SCM_SUPPORTED == 1)
  /* SCM HSE BEGIN */
  SCM_HSE_WaitUntilReady();
  /* SCM HSE END */
#else
  while (LL_RCC_HSE_IsReady() == 0);
#endif /* CFG_SCM_SUPPORTED */

  UTILS_ENTER_LIMITED_CRITICAL_SECTION(RCC_INTR_PRIO << 4U);
  scm_hserdy_isr();
  UTILS_EXIT_LIMITED_CRITICAL_SECTION();
#endif /* STM32WBAXX_SI_CUT1_0 */
#endif /* CFG_LPM_LEVEL */
  return;
}

void UTIL_SEQ_PostIdle( void )
{
#if ( CFG_LPM_LEVEL != 0)
  LL_AHB5_GRP1_EnableClock(LL_AHB5_GRP1_PERIPH_RADIO);
  (void)ll_sys_dp_slp_exit();
  UTIL_LPM_SetOffMode(1U << CFG_LPM_LL_DEEPSLEEP, UTIL_LPM_ENABLE);
#endif /* CFG_LPM_LEVEL */
  /* USER CODE BEGIN UTIL_SEQ_PostIdle_2 */
#if ( (CFG_LPM_LEVEL != 0) && ( CFG_LPM_STDBY_SUPPORTED != 0 ) )
  APP_BSP_PostIdle();
#endif /* ( CFG_LPM_LEVEL && CFG_LPM_STDBY_SUPPORTED ) */
  /* USER CODE END UTIL_SEQ_PostIdle_2 */
  return;
}

void BPKACB_Process( void )
{
  UTIL_SEQ_SetTask(1U << CFG_TASK_BPKA, CFG_SEQ_PRIO_0);
}

/**
 * @brief Callback used by Random Number Generator to launch Task to generate Random Numbers
 */
void HWCB_RNG_Process( void )
{
  UTIL_SEQ_SetTask(1U << CFG_TASK_HW_RNG, TASK_PRIO_RNG);
}

void AMM_RegisterBasicMemoryManager (AMM_BasicMemoryManagerFunctions_t * const p_BasicMemoryManagerFunctions)
{
  /* Fulfill the function handle */
  p_BasicMemoryManagerFunctions->Init = AMM_WrapperInit;
  p_BasicMemoryManagerFunctions->Allocate = AMM_WrapperAllocate;
  p_BasicMemoryManagerFunctions->Free = AMM_WrapperFree;
}

void AMM_ProcessRequest(void)
{
  /* Trigger to call Advance Memory Manager process function */
  UTIL_SEQ_SetTask(1U << CFG_TASK_AMM, CFG_SEQ_PRIO_0);
}

static void AMM_WrapperInit(uint32_t * const p_PoolAddr, const uint32_t PoolSize)
{
  UTIL_MM_Init ((uint8_t *)p_PoolAddr, ((size_t)PoolSize * sizeof(uint32_t)));
}

static uint32_t * AMM_WrapperAllocate(const uint32_t BufferSize)
{
  return (uint32_t *)UTIL_MM_GetBuffer (((size_t)BufferSize * sizeof(uint32_t)));
}

static void AMM_WrapperFree (uint32_t * const p_BufferAddr)
{
  UTIL_MM_ReleaseBuffer ((void *)p_BufferAddr);
}

void FM_ProcessRequest(void)
{
  /* Trigger to call Flash Manager process function */
  UTIL_SEQ_SetTask(1U << CFG_TASK_FLASH_MANAGER, CFG_SEQ_PRIO_0);
}

#if ((CFG_LOG_SUPPORTED == 0) && (CFG_LPM_LEVEL != 0))
/* RNG module turn off HSI clock when traces are not used and low power used */
void RNG_KERNEL_CLK_OFF(void)
{
  LL_RCC_HSI_Disable();
}

#if (CFG_SCM_SUPPORTED == 1)
/* SCM module turn off HSI clock when traces are not used and low power used */
void SCM_HSI_CLK_OFF(void)
{
  LL_RCC_HSI_Disable();
}
#endif /* CFG_SCM_SUPPORTED */
#endif /* ((CFG_LOG_SUPPORTED == 0) && (CFG_LPM_LEVEL != 0)) */

#if (CFG_LOG_SUPPORTED != 0)
void UTIL_ADV_TRACE_PreSendHook(void)
{
#if (CFG_LPM_LEVEL != 0)
  /* Disable Stop mode before sending a LOG message over UART */
  UTIL_LPM_SetStopMode(1U << CFG_LPM_LOG, UTIL_LPM_DISABLE);
#endif /* (CFG_LPM_LEVEL != 0) */
  /* USER CODE BEGIN UTIL_ADV_TRACE_PreSendHook */
#if (CFG_TEST_VALIDATION == 1)
#if ((CFG_LPM_LEVEL != 0) && (CFG_LPM_STDBY_SUPPORTED == 1))
    UTIL_LPM_SetOffMode(1U << CFG_LPM_LOG, UTIL_LPM_DISABLE);
#endif /* ((CFG_LPM_LEVEL != 0) && (CFG_LPM_STDBY_SUPPORTED == 1)) */
#endif /* (CFG_TEST_VALIDATION == 1) */
  /* USER CODE END UTIL_ADV_TRACE_PreSendHook */
}

void UTIL_ADV_TRACE_PostSendHook(void)
{
#if (CFG_LPM_LEVEL != 0)
  /* Enable Stop mode after LOG message over UART sent */
  UTIL_LPM_SetStopMode(1U << CFG_LPM_LOG, UTIL_LPM_ENABLE);
#endif /* (CFG_LPM_LEVEL != 0) */
  /* USER CODE BEGIN UTIL_ADV_TRACE_PostSendHook */
#if (CFG_TEST_VALIDATION == 1)
#if ((CFG_LPM_LEVEL != 0) && (CFG_LPM_STDBY_SUPPORTED == 1))
    UTIL_LPM_SetOffMode(1U << CFG_LPM_LOG, UTIL_LPM_ENABLE);
#endif /* ((CFG_LPM_LEVEL != 0) && (CFG_LPM_STDBY_SUPPORTED == 1)) */
#endif /* (CFG_TEST_VALIDATION == 1) */
  /* USER CODE END UTIL_ADV_TRACE_PostSendHook */
}

/**
 * @brief  Treat Serial commands.
 *
 * @param  pRxBuffer      Pointer on received data from USART.
 * @param  iRxBufferSize  Number of received data.
 * @retval None
 */
void Serial_CMD_Interpreter_CmdExecute( uint8_t * pRxBuffer, uint16_t iRxBufferSize )
{
  /* USER CODE BEGIN Serial_CMD_Interpreter_CmdExecute_1 */

  /* USER CODE END Serial_CMD_Interpreter_CmdExecute_1 */
}

#endif /* (CFG_LOG_SUPPORTED != 0) */

/* USER CODE BEGIN FD_WRAP_FUNCTIONS */
void HAL_GPIO_EXTI_Falling_Callback(uint16_t GPIO_Pin)
{
  HAL_GPIO_EXTI_Rising_Callback(GPIO_Pin);
}

/* USER CODE END FD_WRAP_FUNCTIONS */
