stm32-hotspot/STM32WBA-Advanced-BLE-Broadcast-Speaker/Projects/BLE_Speaker/Applications/BLE/BLE_Audio_Broadcast_Speaker/Core/Src/stm32wbaxx_it.c

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

/* Includes ------------------------------------------------------------------*/
#include "main.h"
#include "stm32wbaxx_it.h"
#include "app_conf.h"
#include "ll_sys.h"
#include "stm32wbaxx_hal.h"
#include "scm.h"
/* USER CODE BEGIN Includes */
#include "BLE_Speaker_WBA5_bsp_audio.h"
#include "codec_mngr.h"

/* USER CODE END Includes */

/* External functions --------------------------------------------------------*/
extern void (*radio_callback)(void);
extern void (*low_isr_callback)(void);

/* External variables --------------------------------------------------------*/
extern volatile uint8_t radio_sw_low_isr_is_running_high_prio;
extern RTC_HandleTypeDef hrtc;
extern DMA_HandleTypeDef handle_GPDMA1_Channel0;
extern UART_HandleTypeDef huart1;
/******************************************************************************/
/*           Cortex Processor Interruption and Exception Handlers          */
/******************************************************************************/
/**
  * @brief This function handles Non maskable interrupt.
  */
void NMI_Handler(void)
{
  /* USER CODE BEGIN NonMaskableInt_IRQn 1 */
  while(1)
  {
  }

  /* USER CODE END NonMaskableInt_IRQn 1 */
}

/**
  * @brief This function handles Hard fault interrupt.
  */
void HardFault_Handler(void)
{
  /* USER CODE BEGIN HardFault_IRQn 0 */
#if (RELEASE == 1)
  HAL_NVIC_SystemReset();
#endif /* RELEASE == 1 */
  /* USER CODE END HardFault_IRQn 0 */
  while (1)
  {
  }
}

/**
  * @brief This function handles Memory management fault.
  */
void MemManage_Handler(void)
{
  while (1)
  {
  }
}

/**
  * @brief This function handles Prefetch fault, memory access fault.
  */
void BusFault_Handler(void)
{
  while (1)
  {
  }
}

/**
  * @brief This function handles Undefined instruction or illegal state.
  */
void UsageFault_Handler(void)
{
  while (1)
  {
  }
}

/**
  * @brief This function handles System service call via SWI instruction.
  */
void SVC_Handler(void)
{
}

/**
  * @brief This function handles Debug monitor.
  */
void DebugMon_Handler(void)
{
}

/**
  * @brief This function handles Pendable request for system service.
  */
void PendSV_Handler(void)
{
}

/**
  * @brief This function handles System tick timer.
  */
void SysTick_Handler(void)
{
  HAL_IncTick();
}

/******************************************************************************/
/* STM32WBAxx Peripheral Interrupt Handlers                                    */
/* Add here the Interrupt Handlers for the used peripherals.                  */
/* For the available peripheral interrupt handler names,                      */
/* please refer to the startup file (startup_stm32wbaxx.s).                    */
/******************************************************************************/

/**
  * @brief This function handles RTC non-secure interrupt.
  */
void RTC_IRQHandler(void)
{
  HAL_RTC_AlarmIRQHandler(&hrtc);
  HAL_RTCEx_SSRUIRQHandler(&hrtc);
}

/**
  * @brief This function handles RCC non-secure global interrupt.
  */
void RCC_IRQHandler(void)
{
  /* USER CODE BEGIN RCC_IRQn 0 */
  if(__HAL_RCC_GET_IT(RCC_IT_PLL1RDY))
  {
    PLL_Ready_ProcessIT();
  }

  /* USER CODE END RCC_IRQn 0 */
  /* Check the RCC interrupt source */
  if(__HAL_RCC_GET_IT(RCC_IT_HSERDY))
  {
    __HAL_RCC_CLEAR_IT(RCC_IT_HSERDY);
#if (CFG_SCM_SUPPORTED == 1)
    /* SCM HSE BEGIN */
    SCM_HSE_StartStabilizationTimer();
    /* SCM HSE END */
#endif /* CFG_SCM_SUPPORTED */
  }
  else if(__HAL_RCC_GET_IT(RCC_IT_PLL1RDY))
  {
    __HAL_RCC_CLEAR_IT(RCC_IT_PLL1RDY);
#if (CFG_SCM_SUPPORTED == 1)
    scm_pllrdy_isr();
#endif /* CFG_SCM_SUPPORTED */
  }
}

/**
  * @brief This function handles EXTI Line0 interrupt.
  */
void EXTI0_IRQHandler(void)
{
  HAL_GPIO_EXTI_IRQHandler(GPIO_PIN_0);
}

/**
  * @brief This function handles EXTI Line3 interrupt.
  */
void EXTI3_IRQHandler(void)
{
  HAL_GPIO_EXTI_IRQHandler(GPIO_PIN_3);
}

/**
  * @brief This function handles EXTI Line8 interrupt.
  */
void EXTI8_IRQHandler(void)
{
  HAL_GPIO_EXTI_IRQHandler(GPIO_PIN_8);
}

/**
  * @brief This function handles EXTI Line9 interrupt.
  */
void EXTI9_IRQHandler(void)
{
  HAL_GPIO_EXTI_IRQHandler(GPIO_PIN_9);
}

/**
  * @brief This function handles EXTI Line10 interrupt.
  */
void EXTI10_IRQHandler(void)
{
  HAL_GPIO_EXTI_IRQHandler(GPIO_PIN_10);
}

/**
  * @brief This function handles EXTI Line13 interrupt.
  */
void EXTI13_IRQHandler(void)
{
  HAL_GPIO_EXTI_IRQHandler(GPIO_PIN_13);
}

/**
  * @brief This function handles GPDMA1 Channel 0 global interrupt.
  */
void GPDMA1_Channel0_IRQHandler(void)
{
  HAL_DMA_IRQHandler(&handle_GPDMA1_Channel0);
}

/**
  * @brief This function handles USART1 global interrupt.
  */
void USART1_IRQHandler(void)
{
  HAL_UART_IRQHandler(&huart1);
}

/**
  * @brief This function handles TIM16 global interrupt.
  */
void TIM16_IRQHandler(void)
{
  /* Check whether update interrupt is pending */
  if(LL_TIM_IsActiveFlag_UPDATE(TIM16) == 1)
  {
    /* Clear the update interrupt flag */
    LL_TIM_ClearFlag_UPDATE(TIM16);

#if (CFG_SCM_SUPPORTED == 1)
    /* SCM HSE BEGIN */
    /* Update interrupt processing */
    SCM_HSE_SW_HSERDY_isr();
    /* SCM HSE END */
#endif /* CFG_SCM_SUPPORTED */
  }
}

/**
  * @brief This function handles 2.4GHz RADIO global interrupt.
  */
void RADIO_IRQHandler(void)
{
  if(NULL != radio_callback)
  {
    radio_callback();
  }

  LL_RCC_RADIO_DisableSleepTimerClock();
  __ISB();

}

/**
  * @brief This function handles HASH global interrupt.
  */
void HASH_IRQHandler(void)
{
  /* Disable SW radio low interrupt to prevent nested calls */
  NVIC_DisableIRQ(RADIO_SW_LOW_INTR_NUM);

  if(NULL != low_isr_callback) {
    low_isr_callback();
  }

  /* Check if nested SW radio low interrupt has been requested*/
  if(radio_sw_low_isr_is_running_high_prio != 0) {
    HAL_NVIC_SetPriority((IRQn_Type) RADIO_SW_LOW_INTR_NUM, RADIO_INTR_PRIO_LOW, 0);
    radio_sw_low_isr_is_running_high_prio = 0;
  }

  /* Re-enable SW radio low interrupt */
  NVIC_EnableIRQ(RADIO_SW_LOW_INTR_NUM);

}

/* USER CODE BEGIN 1 */
/**
  * @brief This function handles GPDMA1 Channel 1 global interrupt.
  */
void GPDMA1_Channel1_IRQHandler(void)
{
  BSP_AUDIO_IN_IRQHandler(0,0);
}

/**
  * @brief This function handles GPDMA1 Channel 2 global interrupt.
  */
void GPDMA1_Channel2_IRQHandler(void)
{
  BSP_AUDIO_OUT_IRQHandler(0,0);
}

/**
  * @brief This function handles interrupt used for Codec Manager
  */
void COMP_IRQHandler(void)
{
  /* Call codec manager */
  CODEC_ManagerProcess();
}
/* USER CODE END 1 */
