stm32-hotspot/STM32WBA-Advanced-BLE-Broadcast-Speaker/(notices)

Notices in the files:
Projects/STM32WBA65I-DK1/Applications/BLE/BLE_Audio_Broadcast_Speaker/Core/Src/app_entry.c:
Copyright (c) 2022 STMicroelectronics.
All rights reserved.
